GaudiLabs/qPocketPCR/Software/BOOT_Reset.jpg

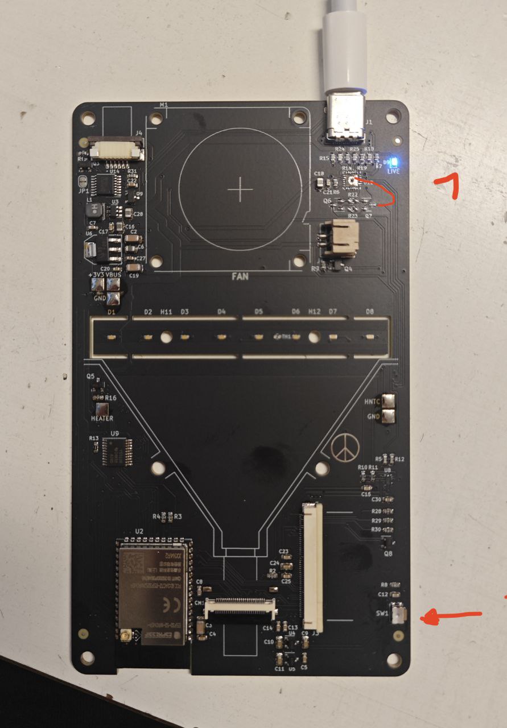
Software/BOOT_Reset.jpg
