GaudiLabs/qPocketPCR/README.md

# qPocketPCR
Quantitative PCR machine detecting fluorescence using a camera
