GaudiLabs/qPocketPCR/Electronics/LaserLid/LaserLid/LaserLid2.png

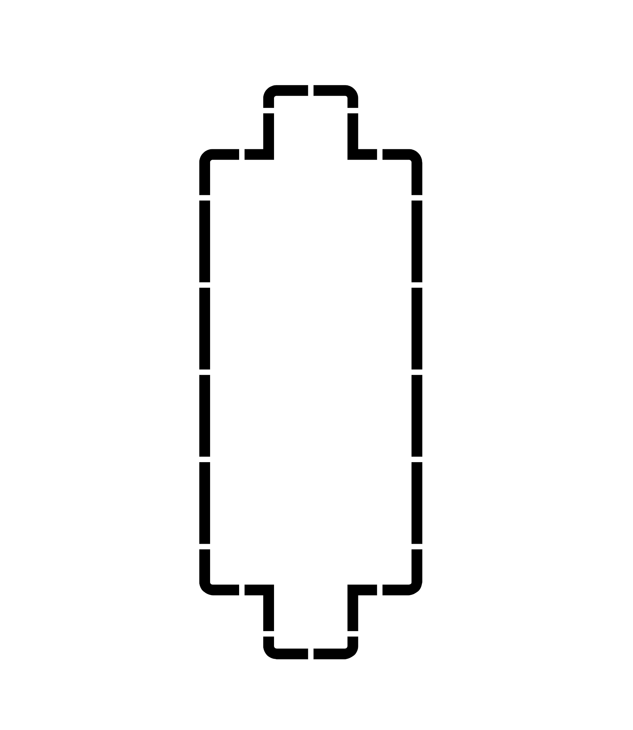
Electronics/LaserLid/LaserLid/LaserLid2.png
