GaudiLabs/qPocketPCR/Electronics/LaserLid/LaserLid/LaserLidHalve2.png

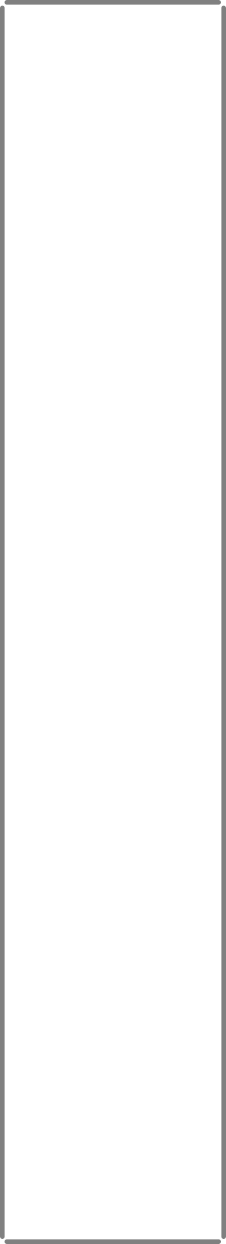
Electronics/LaserLid/LaserLid/LaserLidHalve2.png
