GaudiLabs/qPocketPCR/Electronics/TopCoverQPCR/FrontSilk.png

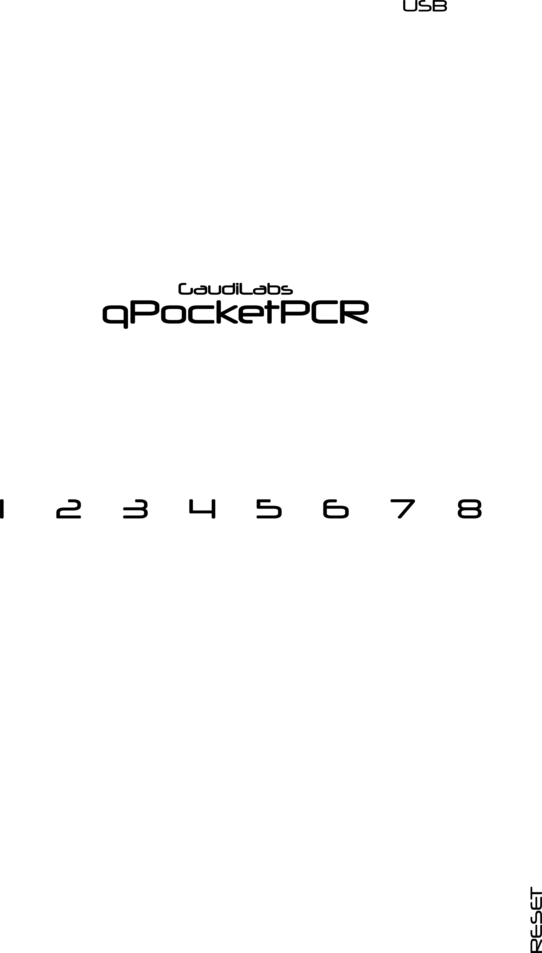
Electronics/TopCoverQPCR/FrontSilk.png
