GaudiLabs/qPocketPCR/Electronics/TopCoverQPCR/pattV2.png

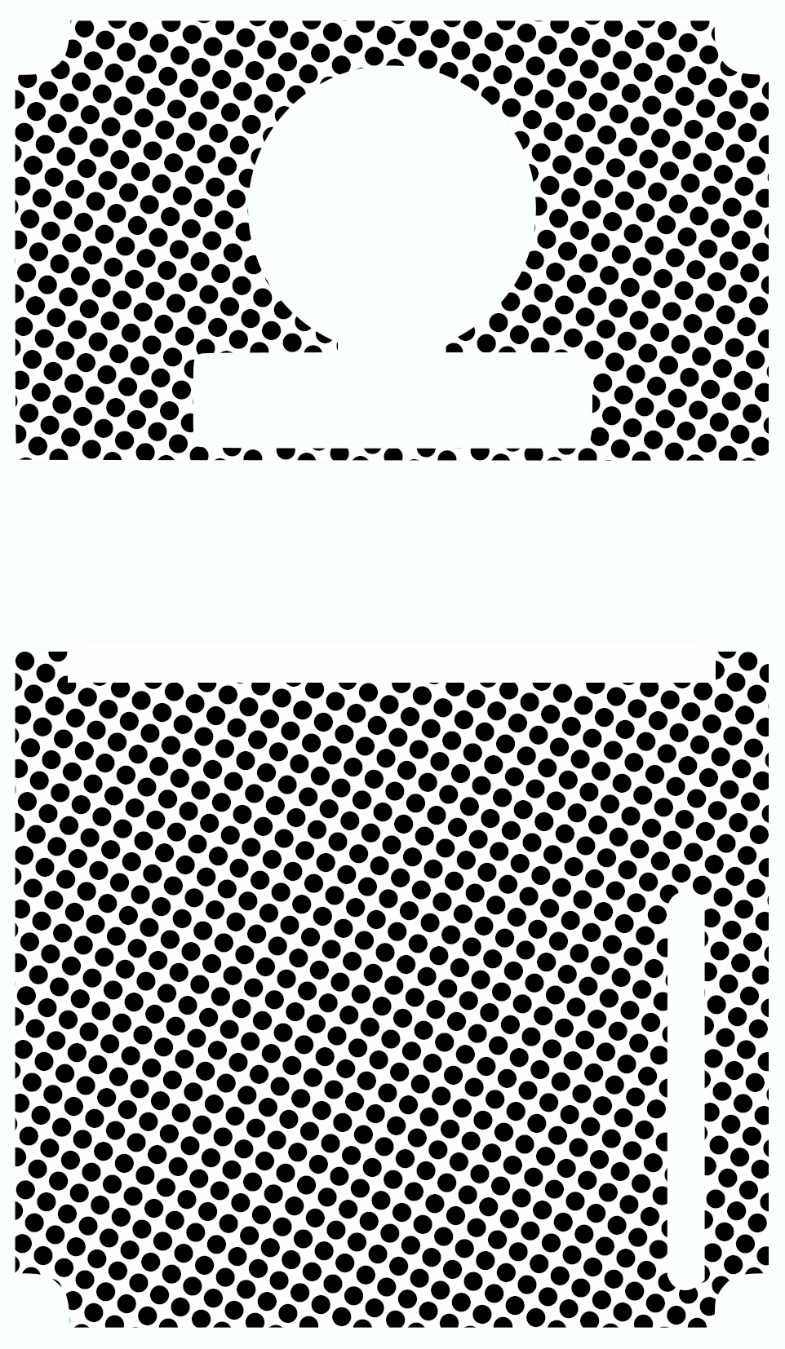
Electronics/TopCoverQPCR/pattV2.png
