GaudiLabs/qPocketPCR/Electronics/TopCoverQPCR/SilverBrim.png

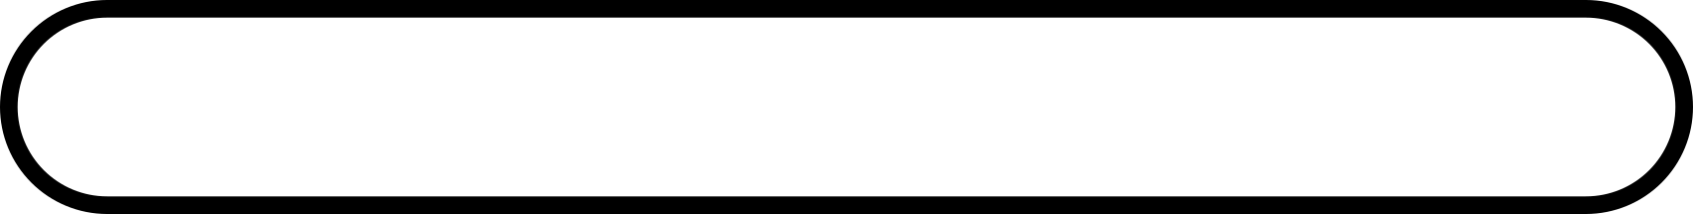
Electronics/TopCoverQPCR/SilverBrim.png
