GaudiLabs/qPocketPCR/Electronics/TopCoverQPCR/text19348-3.png

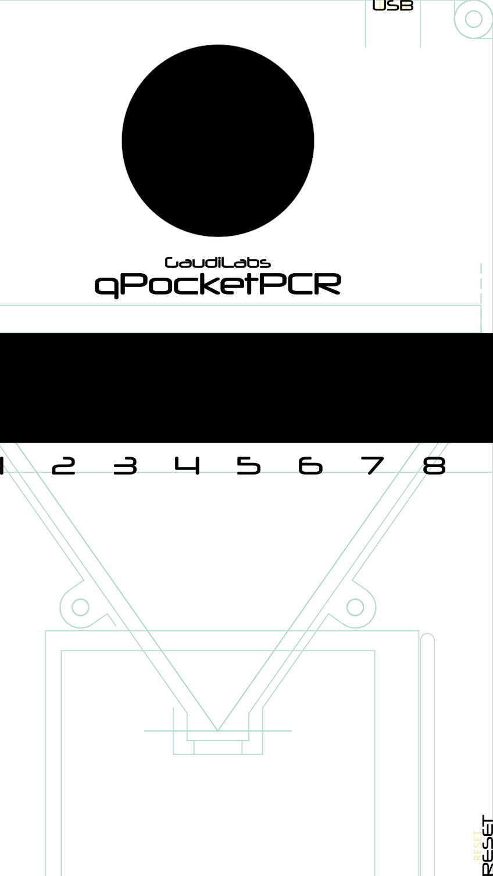
Electronics/TopCoverQPCR/text19348-3.png
