GaudiLabs/qPocketPCR/Software/SettingsqPCR.png

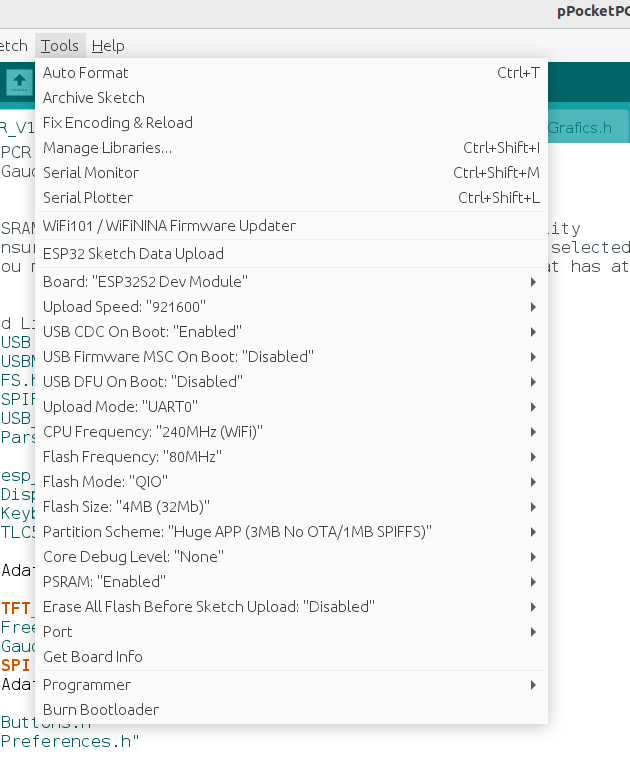
Software/SettingsqPCR.png
