GaudiLabs/qPocketPCR/Electronics/qPocketPCR_Main/qPocketPCR_Main/qCamPCR_V2_BOM.ods

 |  | BOM qPCR
Id | Quantity | Designator | Package | Designation | Supplier | Supplier and ref | Stock | Need for 25 | Stock 20205 | Ordered
1 | 1 | CM1 | FFC_MOLEX_EASYON_05mm_24_INVERTED | CAM_OV7725 | Shenzhen Duoweisi Tech Co., Ltd. |  | ok | 25 | 100
 |  |  |  | Camera Lenses | huidongbao Official Store |  |  | 25 | 100
1 |  | CM1 |  | FFC Connector 24P inverse, 5-1734592-0 | mouser | 571-5-1734592-0 |  | 25 | 10 | 20
34 | 1 | U2 | ESP32-S2-WROVER | ESP32-S2-WROVER-I(M22S2H3216UH3Q0) | mouser | 356-ESP32S2WRVI321PH | order | 25 | 1 | 50
36 | 1 | U3 | TSOT-23-6 | AP63205WU | mouser | 621-AP63205WU-7 | 9 | 25 |  | 25
12 | 1 | U4 | SOT-23 | XC6206P282MR-G | mouser | 865-XC6206P282MR-G | 8 | 25 | 3 | 25
4 | 1 | U5 | SOT-23 | XC6206P122MR-G | mouser | 865-XC6206P122MR-G | 8 | 25 | 3 | 25
35 | 1 | U6 | SOT-223 | TLV1117-33 | mouser | 595-TLV1117LV33DCYR | 8 | 25 | 5 | 25
38 | 1 | U8 | Texas_R-PUQFN-N10 | TLA2024 | digikey | TLA2024IRUGR | order | 25 | 5 | 25
42 | 1 | U9 | TSSOP-20_4.4x6.5mm_P0.65mm | TLC59108xPW | digikey | TLC59108IPWR |  | 25 | 4 | 25
37 | 1 | U12 | QFN-24-1EP_4x4mm_P0.5mm_EP2.6x2.6mm | CP2104 |  |  | 5 |  | 2
33 | 1 | U14 | TSSOP-16_4.4x5mm_P0.65mm | IP2721_MAX12 | Aliexpress |  | 8 | 25 | 3 | 25
21 | 5 | Q3,Q4,Q5,Q8,Q9 | SOT-23 | Q_NMOS_GSD, AO3420 |  |  | order | 125 | 50 | 100
25 | 2 | Q6,Q7 | SOT-23 | BC847_NPN_BEC |  |  | 100
5 | 8 | D1,D2,D3,D4,D5,D7,D6,D8 | LED_SMD_WL-SMCW | LED WL-SMCW (150060BS84000) | LB Q39G-L200-35-1 | 720-LBQ39GL2N2351 |  | 200 | 40 | 200
23 | 1 | D9 | LED_0603_1608Metric | LED green |  |  | ok | 25
39 | 1 | L1 | L_Vishay_IFSC-1515AH_4x4x1.8mm | 4.7uHNRS4018T4R7MDGJ | digikey | 587-2893-2-ND | 10 | 25 | 5 | 25 | +10 other?
30 | 1 | LID | C_0402_1005Metric | Thermistor_NTC |  |  | ok
 | 1 | TH1 |  | NXFT15XV103FEAB021 | mouser | 81-NXFT15XV103FEAB21 |  |  | 4 | 25
15 | 3 | C2,C3,C19 | C_1206_3216Metric | 100uF |  |  | ok
16 | 14 | C4,C5,C7,C12,C13,C15,C20,C21,C23,C25,C27,C14,C30,C17 | C_0603_1608Metric | 100nF |  |  | ok
17 | 4 | C6,C28,C18,C16 | C_0805_2012Metric | 22uF |  | 47uF | ok
18 | 1 | C8 | C_0603_1608Metric | 15pF |  |  | ok
19 | 4 | C9,C10,C11,C24 | C_0805_2012Metric | 10uF |  |  | ok
31 | 1 | C22 | C_0603_1608Metric | 1uF |  |  | ok
6 | 6 | R1, R2,R3,R4,R9,R16 | R_0603_1608Metric | 4.7k
 | 2 | R10,R11 | R_0603_1608Metric | 4.7k 0.1%
7 | 4 | R7,R8,R12 | R_0603_1608Metric | 1k
8 | 3 | R28,R29,R30 | R_0603_1608Metric | 18R
9 | 4 | R24,R25,R14,R15 | R_0603_1608Metric | 22R
10 | 2 | R18,R19 | R_0603_1608Metric | 5k1
11 | 1 | R31 | R_0603_1608Metric | 100k
41 | 1 | R13 | R_0603_1608Metric | 3.3k |  |  | 100 | 25 | 95
24 | 3 | R23,R22,R6,R5 | R_0603_1608Metric | 10k
27 | 1 | SW1 | SW_SPST_KMS221GLFS | SW_Push |  |  | ok
2 | 1 | J1 | USB_C_Receptacle_Amphenol_12401610E4-2A | USB_C_Receptacle |  |  | ok | 25 | 25
22 | 1 | J2 | JSP_PH_20_SMD_RIGHT_ANGLE | FAN_12V | Aliexpress |  | 4 | 25 | 15 | 60
3 | 1 | Disp | ER-TFT022_1 | ER-TFT022-1 | buydisplay.com | ER-TFT022-1, 2.2“, Capacitive Touch Panel | 8 | 25 | 5
 | 1 | J3 |  | 50 pin ZIF connector | digikey | A100227CT-ND |  | 25 | 3 | 25
 | 1 | J4 |  | FFC Connector 6pin, FFC3B07-06-T | mouser | 640-FFC3B07-06-T |  | 25 | 9 | 25
 |  | Lid Cable |  | FFC Cable 6pin 1mm, Capton | Aliexpress |  |  |  |  | 10
43 | 1 | M1 | 4010FanRadial | Fan, Radial Blower 12v |  |  | 4 | 25 | 2 | 8
 | 1 |  |  | Thermal Conductive Paste |  |  | 1
 |  |  |  | Graphite Sheet |  |  | 1
 | 1 |  |  | Heatblock |  |  |  | 25 | 3
 | 1 |  |  | PCB Lid |  |  |  | 25
 | 1 |  |  | PCB Top Cover |  |  |  | 25
 | 1 |  |  | PCB Main |  |  |  | 25
 | 1 |  |  | 3D printed frame |  |  |  | 25
 | 1 |  |  | 3D printed Display Bezzel |  |  |  | 25
 | 1 |  |  | 3D printed Lid |  |  |  | 25
 | 1 |  |  | 3D printed corner left
 | 1 |  |  | 3D printed corner right
 | 2 |  |  | Sink Screw 5mm | BN3803. M2.5 x 5 mm, 83.1325.02505
 | 8 |  |  | Screw Black M3 x 8
 | 4 |  |  | Screws Black M2.5x 8 (6)
 | 4 |  |  | Spacers M3x10mm
 | 1 |  |  | Foam for heated lid
 | 1 |  |  | Silicon Heat pad
 | 1 |  |  | 0.2mm Laser Lid
 | 1 |  |  | Filter blue | (HT)*141 BRIGHT BLUE p72
 | 1 |  |  | Filter orange | 780 AS GOLDEN AMBER
 | 1 |  |  | Thermal Conductive Carbon Sheet
13 | 6 | H1,H2,H3,H4,H5,H6 | MountingHole_3.2mm_M3 | CaseMountingHole
29 | 2 | H12,H11 | MountingHole_2.6mm | HeatblockMountingHole
