GaudiLabs/qPocketPCR/Hardware/SolidWorks/qPocketPCR_Assembly.SLDASM

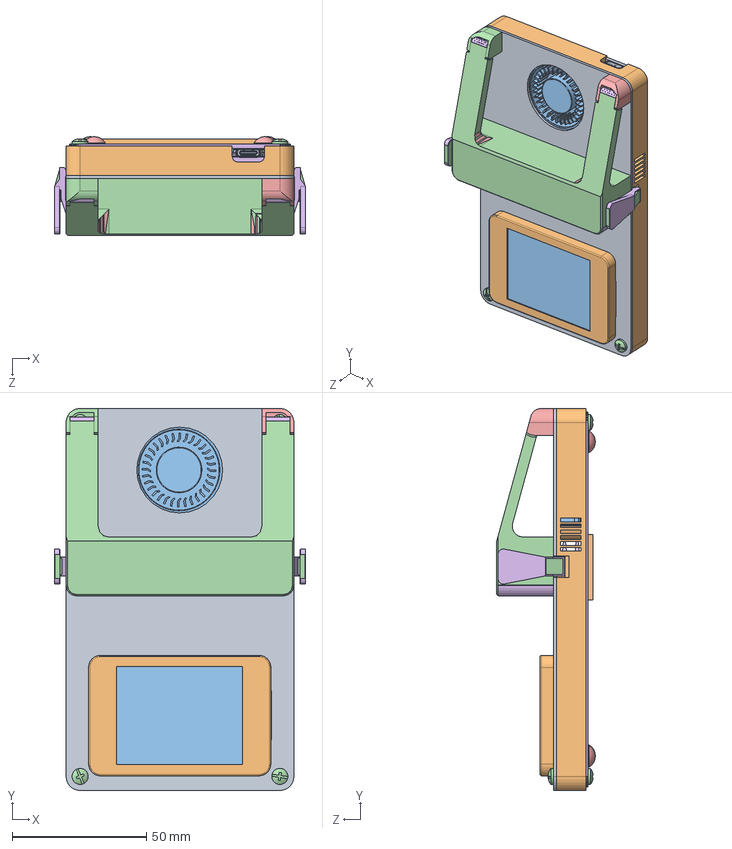
[picture p9: CAD file, 2025-11-05]
Hardware/SolidWorks/qPocketPCR_Assembly.SLDASM
93.8 x 142.5 x 36.8 mm
Frame2
HexNutM3_10 x 4
Screw x 8
Feet x 4
Heatblock451
FilterBlue
Cam
PCBTop
BezzelClip
Display2_2
HingeCorner
HingeCornerMirrored
CapHeatedNewClip
LidHeatGuideSheet
TubeStrip
FilterOrange
CarbonPatch
My4010Blowe
SOLID.step x 9
SOLID-0.step x 26
SOLID-1.step x 3
SOLID-2.step x 16
SOLID-3.step x 8
SOLID-4.step
SOLID-5.step
SOLID-6.step
SOLID-7.step
SOLID-8.step
qPocketPCR_Main PCB.step
BlueLED0402 x 2
NTC_NXFT15
C12401610_3
SiliconPad
