GaudiLabs/qPocketPCR/Electronics/qCamPCB/svg/qCamPCR-brd.dxf

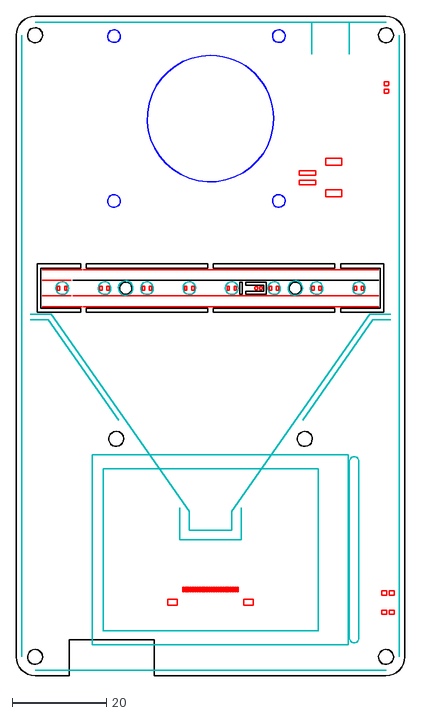
[picture p10: CAD file, 2025-11-05]
Electronics/qCamPCB/svg/qCamPCR-brd.dxf
82.5 x 140.0
