GaudiLabs/qPocketPCR/Electronics/qPocketPCR_Lid/outline.dxf

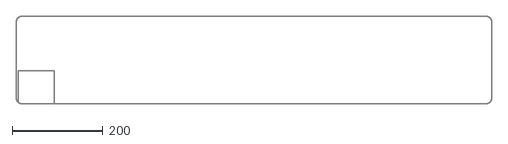
[picture p11: CAD file, 2025-11-05]
Electronics/qPocketPCR_Lid/outline.dxf
1047.6 x 193.3
