GaudiLabs/qPocketPCR/Electronics/TopCoverQPCR/TopCoverCAD.dxf

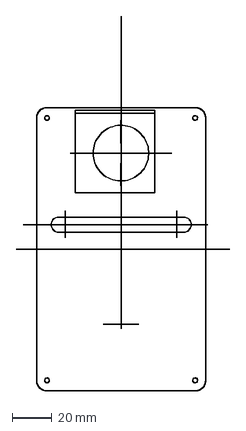
[picture p12: CAD file, 2025-11-05]
Electronics/TopCoverQPCR/TopCoverCAD.dxf
107.6 x 188.5 mm
