GaudiLabs/qPocketPCR/Hardware/SolidWorks/Display2_2.SLDPRT

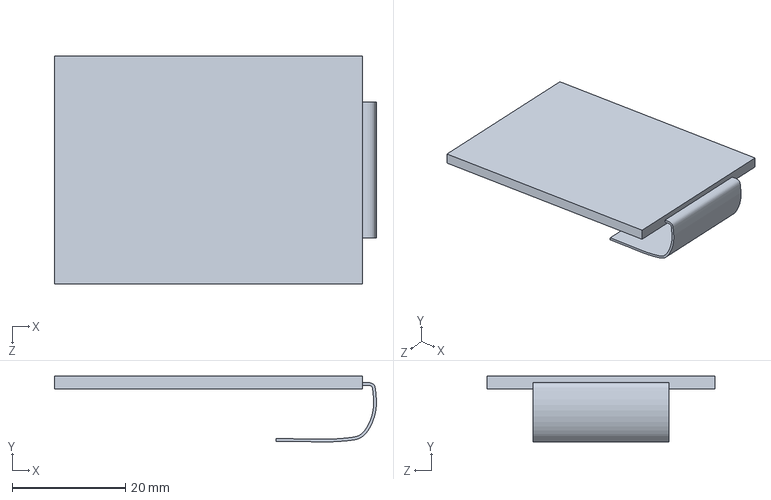
[picture p13: CAD file, 2025-11-05]
Hardware/SolidWorks/Display2_2.SLDPRT
56.9 x 11.6 x 40.3 mm
