GaudiLabs/qPocketPCR/Electronics/qCamPCB/svg/DrawingQpcr.dxf

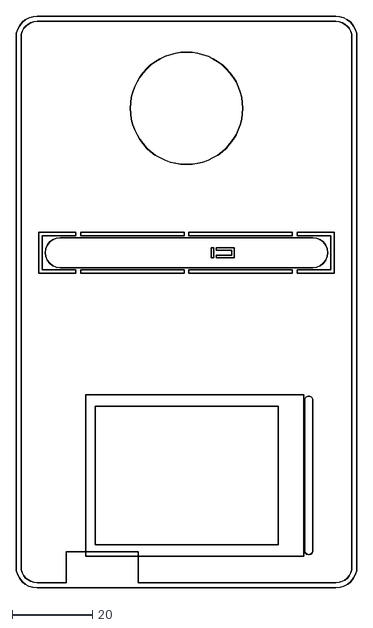
[picture p14: CAD file, 2025-11-05]
Electronics/qCamPCB/svg/DrawingQpcr.dxf
85.0 x 142.5
