GaudiLabs/qPocketPCR/Hardware/SolidWorks/SiliconPad.SLDPRT

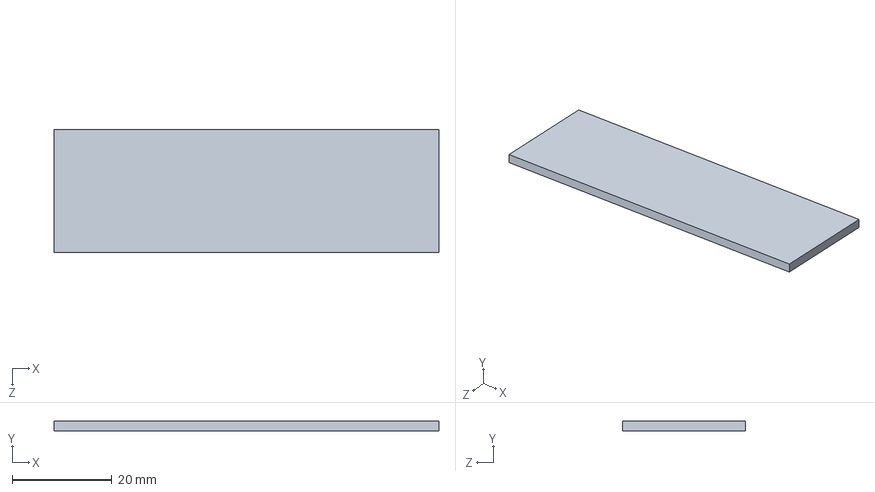
[picture p15: CAD file, 2025-11-05]
Hardware/SolidWorks/SiliconPad.SLDPRT
77.0 x 2.00 x 24.5 mm
