GaudiLabs/qPocketPCR/Hardware/SolidWorks/CarbonPatch.SLDPRT

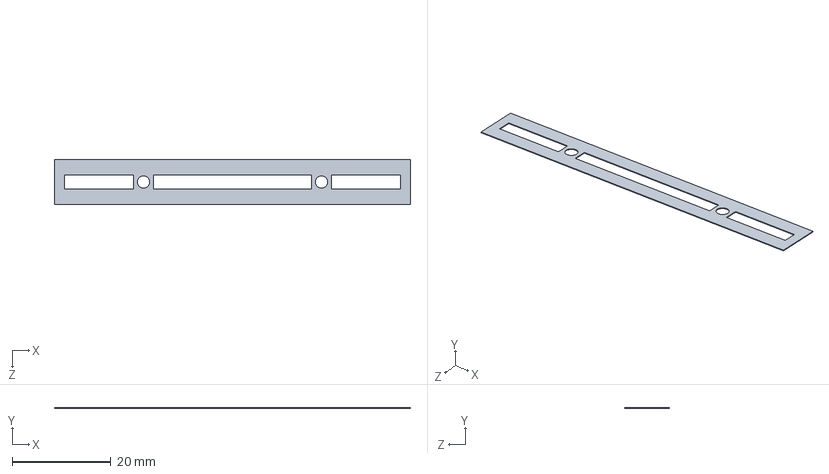
[picture p16: CAD file, 2025-11-05]
Hardware/SolidWorks/CarbonPatch.SLDPRT
72.0 x 0.15 x 9.00 mm
