GaudiLabs/qPocketPCR/Hardware/SolidWorks/My4010Blowe.SLDPRT

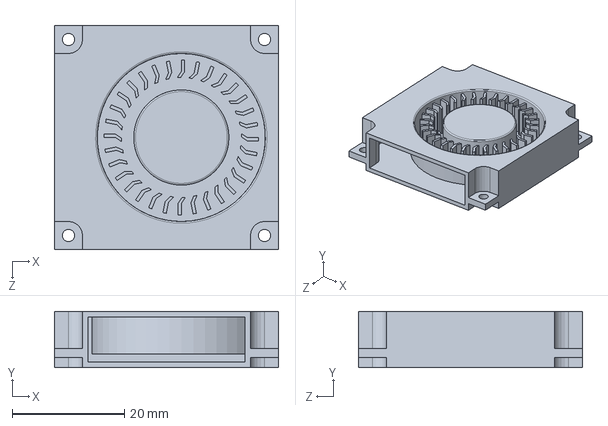
[picture p17: CAD file, 2025-11-05]
Hardware/SolidWorks/My4010Blowe.SLDPRT
40.0 x 10.0 x 40.0 mm
