GaudiLabs/qPocketPCR/Hardware/SolidWorks/HingeCorner.SLDPRT

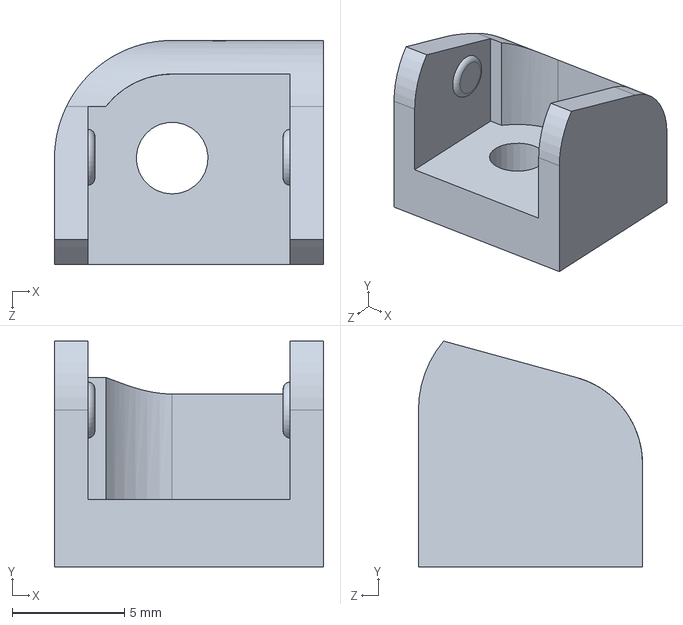
[picture p18: CAD file, 2025-11-05]
Hardware/SolidWorks/HingeCorner.SLDPRT
12.0 x 10.1 x 10.00 mm
