GaudiLabs/qPocketPCR/Hardware/SolidWorks/BlueLED0402.SLDPRT

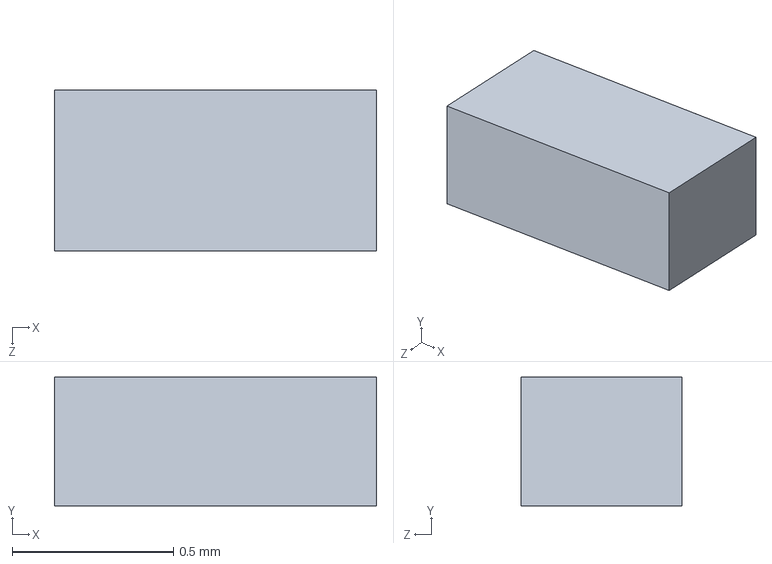
[picture p19: CAD file, 2025-11-05]
Hardware/SolidWorks/BlueLED0402.SLDPRT
1.00 x 0.4 x 0.5 mm
