GaudiLabs/qPocketPCR/Hardware/SolidWorks/Cam.SLDPRT

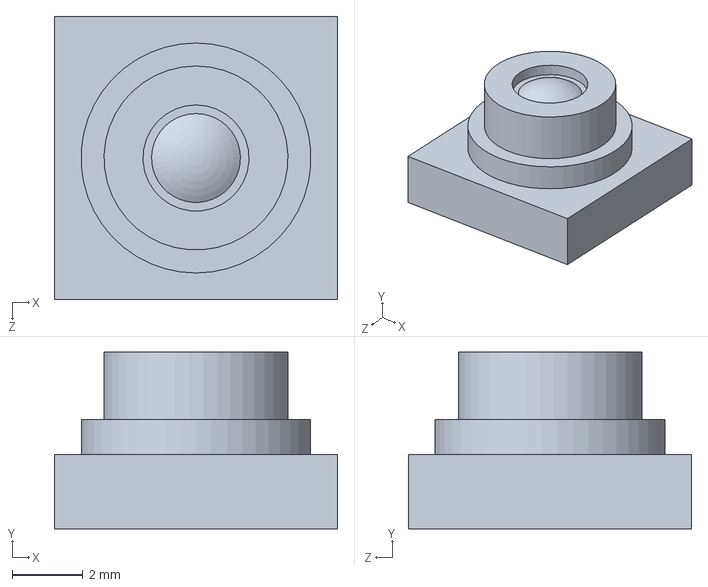
[picture p20: CAD file, 2025-11-05]
Hardware/SolidWorks/Cam.SLDPRT
8.00 x 5.00 x 8.00 mm
