GaudiLabs/qPocketPCR/Hardware/SolidWorks/PCBV12.SLDPRT

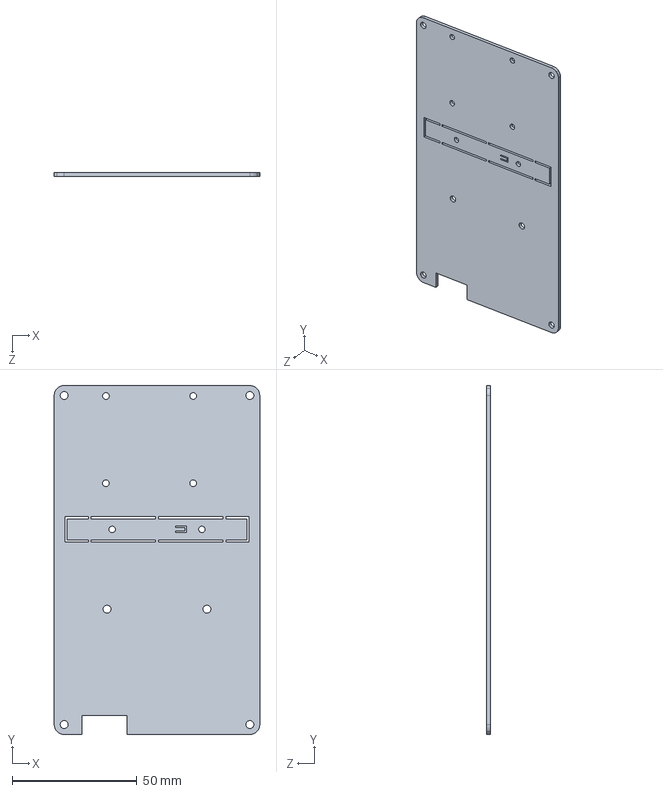
[picture p21: CAD file, 2025-11-05]
Hardware/SolidWorks/PCBV12.SLDPRT
82.5 x 140.0 x 1.60 mm
