GaudiLabs/qPocketPCR/Hardware/SolidWorks/FilterOrange.SLDPRT

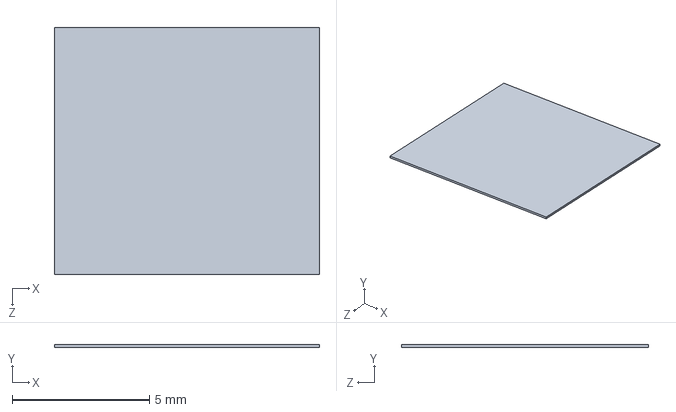
[picture p22: CAD file, 2025-11-05]
Hardware/SolidWorks/FilterOrange.SLDPRT
9.65 x 0.1 x 9.00 mm
