GaudiLabs/qPocketPCR/Hardware/SolidWorks/CapHeatedNewClip.SLDPRT

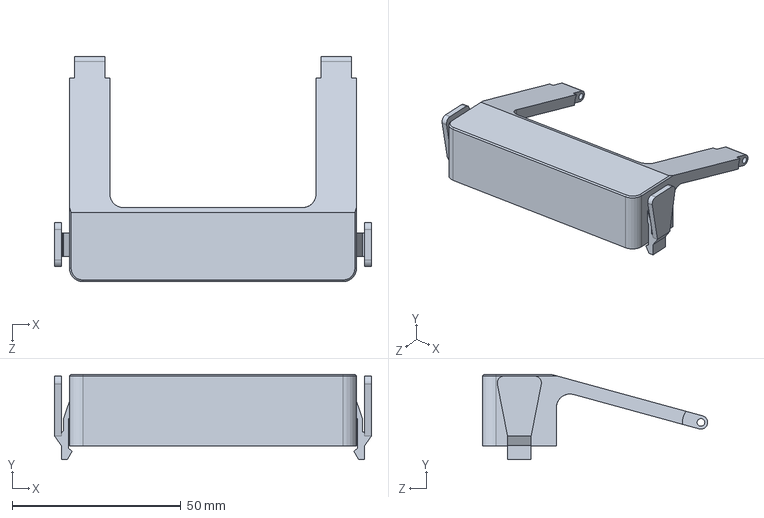
[picture p23: CAD file, 2025-11-05]
Hardware/SolidWorks/CapHeatedNewClip.SLDPRT
93.8 x 25.2 x 66.7 mm
