GaudiLabs/qPocketPCR/Hardware/SolidWorks/PCBTop.SLDPRT

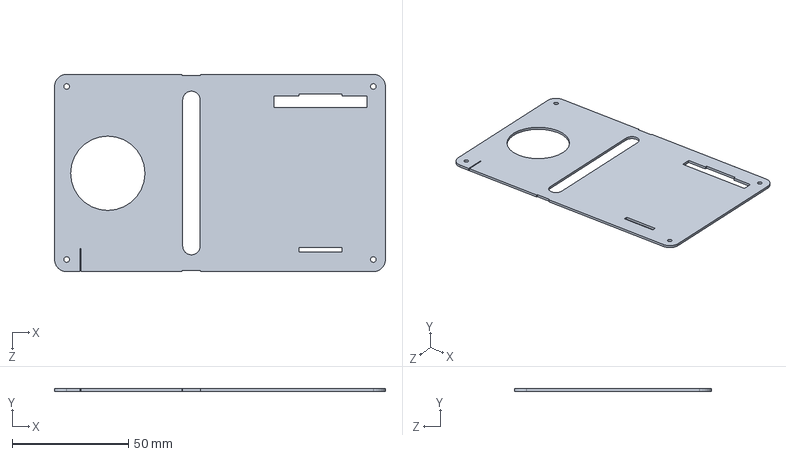
[picture p24: CAD file, 2025-11-05]
Hardware/SolidWorks/PCBTop.SLDPRT
142.5 x 1.20 x 85.0 mm
