GaudiLabs/qPocketPCR/Hardware/SolidWorks/TubeStrip.SLDPRT

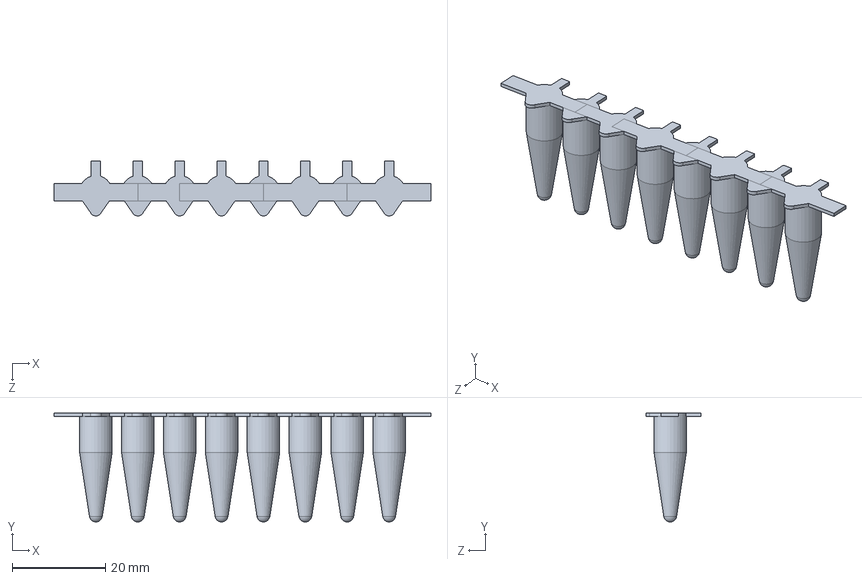
[picture p25: CAD file, 2025-11-05]
Hardware/SolidWorks/TubeStrip.SLDPRT
81.0 x 23.4 x 11.8 mm
