GaudiLabs/qPocketPCR/Hardware/SolidWorks/NTC_NXFT15.SLDPRT

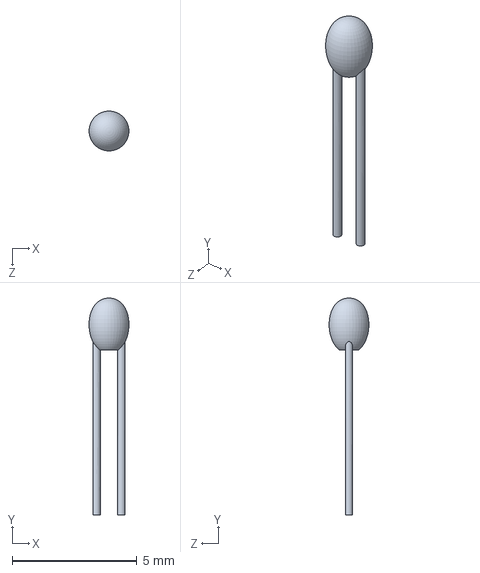
[picture p26: CAD file, 2025-11-05]
Hardware/SolidWorks/NTC_NXFT15.SLDPRT
1.60 x 8.69 x 1.59 mm
