GaudiLabs/qPocketPCR/Hardware/SolidWorks/BezzelClip.SLDPRT

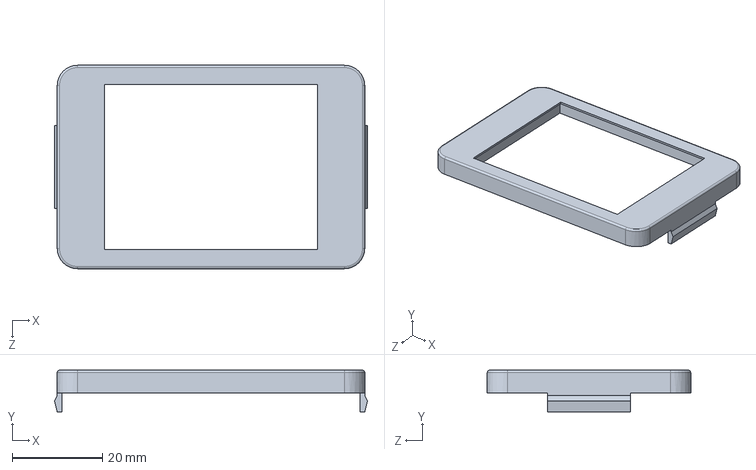
[picture p27: CAD file, 2025-11-05]
Hardware/SolidWorks/BezzelClip.SLDPRT
69.2 x 9.20 x 45.0 mm
