GaudiLabs/qPocketPCR/Hardware/SolidWorks/FilterBlue.SLDPRT

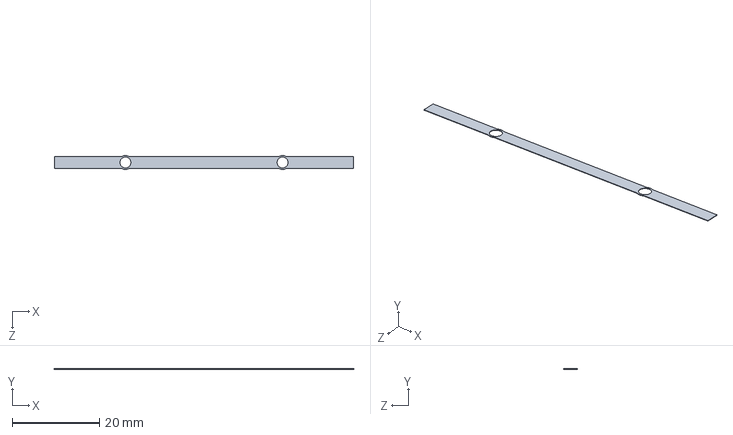
[picture p28: CAD file, 2025-11-05]
Hardware/SolidWorks/FilterBlue.SLDPRT
68.5 x 0.1 x 3.20 mm
