GaudiLabs/qPocketPCR/Hardware/SolidWorks/HexNutM3_10.SLDPRT

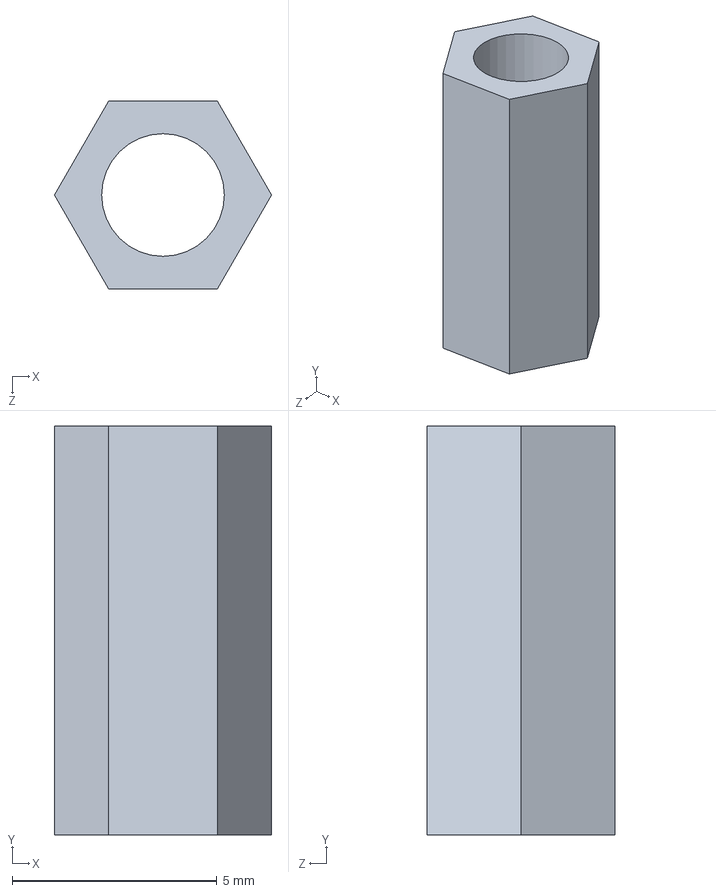
[picture p29: CAD file, 2025-11-05]
Hardware/SolidWorks/HexNutM3_10.SLDPRT
5.31 x 10.0 x 4.60 mm
