GaudiLabs/qPocketPCR/Hardware/SolidWorks/LidHeatGuideSheet.SLDPRT

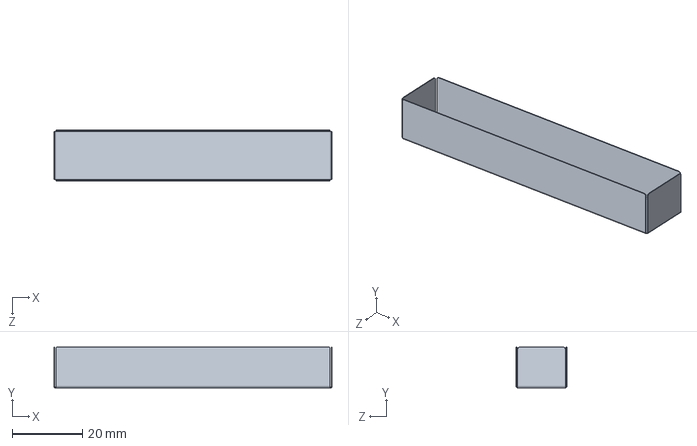
[picture p30: CAD file, 2025-11-05]
Hardware/SolidWorks/LidHeatGuideSheet.SLDPRT
79.0 x 11.6 x 14.4 mm
