GaudiLabs/qPocketPCR/Hardware/SolidWorks/Frame2.SLDPRT

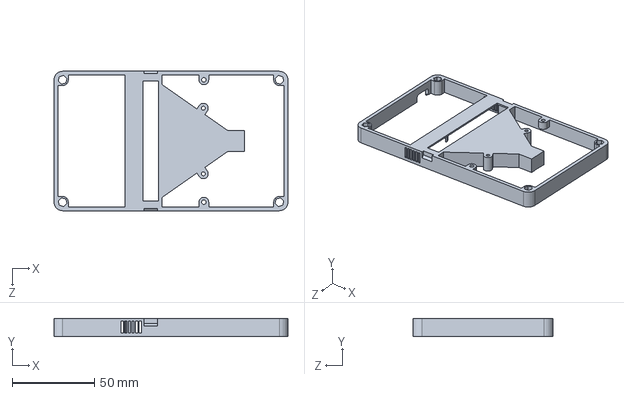
[picture p31: CAD file, 2025-11-05]
Hardware/SolidWorks/Frame2.SLDPRT
142.5 x 11.0 x 85.0 mm
