GaudiLabs/qPocketPCR/Hardware/SolidWorks/Feet.SLDPRT

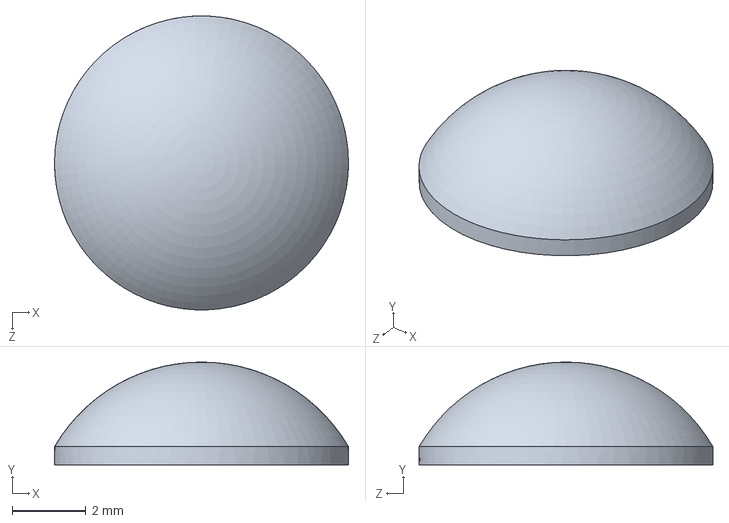
[picture p32: CAD file, 2025-11-05]
Hardware/SolidWorks/Feet.SLDPRT
8.00 x 2.80 x 8.00 mm
