GaudiLabs/qPocketPCR/Hardware/SolidWorks/Heatblock451.SLDPRT

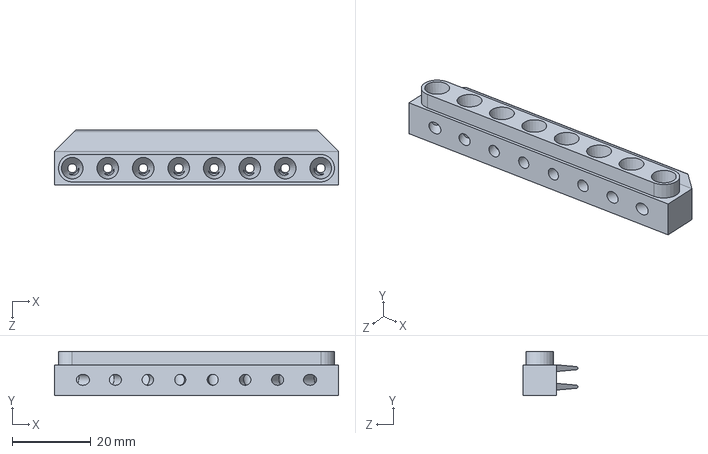
[picture p33: CAD file, 2025-11-05]
Hardware/SolidWorks/Heatblock451.SLDPRT
72.0 x 11.2 x 13.9 mm
