GaudiLabs/qPocketPCR/(list of files, cad)

Other CAD files:
Electronics/LaserLid/LidHeatGuideSheet.DWG
Electronics/qPocketPCR_Lid/#HeatedLidPCB.dwg
Hardware/SolidWorks/HingeCornerMirrored.SLDPRT
Electronics/qPocketPCR_Lid/HeatedLidPCB.dwg
Hardware/SolidWorks/C12401610_3.SLDPRT
Hardware/SolidWorks/Screw.SLDPRT
