GaudiLabs/qPocketPCR/Electronics/LaserLid/LidHeatGuideSheet2.PDF

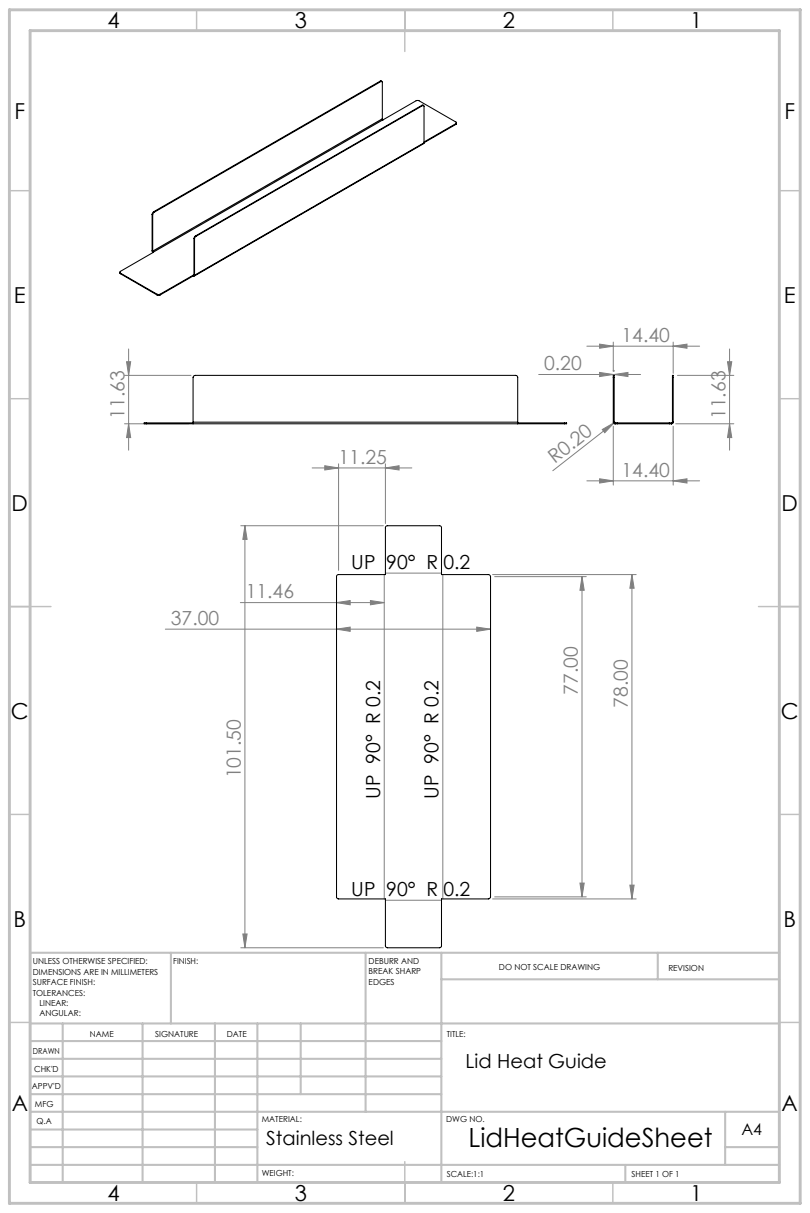
[picture p34: page 1]
FINISH:; DEBURR AND; BREAK SHARP; DO NOT SCALE DRAWING; REVISION; SCALE:1:1; SHEET 1 OF 1

UNLESS OTHERWISE SPECIFIED:
DIMENSIONS ARE IN MILLIMETERS
SURFACE FINISH:
TOLERANCES:
LINEAR:
ANGULAR:

NAME | SIGNATURE | DATE | | | | TITLE: Lid Heat Guide

DRAWN
CHK'D
APPV'D
MFG
Q.A | | | | MATERIAL: Stainless Steel | DWG NO. LidHeatGuideSheet | A4
