GaudiLabs/qPocketPCR/Electronics/qPocketPCR_Lid/qPocketPCR_Lid/qPocketPCR_Lid.kicad_pcb

## KiCad design Electronics/qPocketPCR_Lid/qPocketPCR_Lid/qPocketPCR_Lid.kicad_pcb (2025-11-05)

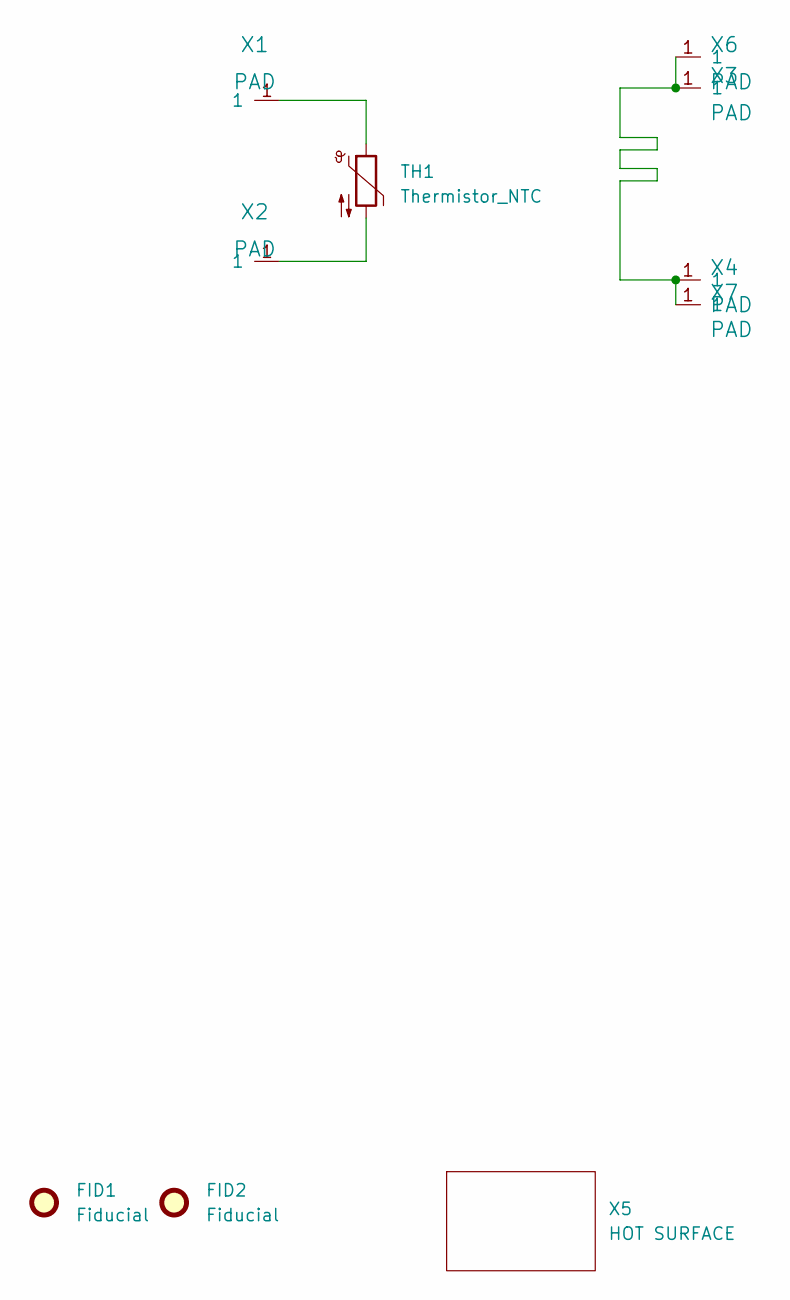
[picture p35: schematic qPocketPCR_Lid.kicad_sch]

Parts:
FID1, FID2: Fiducial; Fiducial_0.5mm_Mask1mm
TH1: Thermistor_NTC; R_0402_1005Metric
X1, X2, X3, X4, X6, X7: PAD; PAD_SMD_FFC
X5: HOT SURFACE; HotSurfaceWarning

Connections:
unnamed: TH1.1, X1.1
unnamed: TH1.2, X2.1
unnamed: X3.1, X4.1, X6.1, X7.1

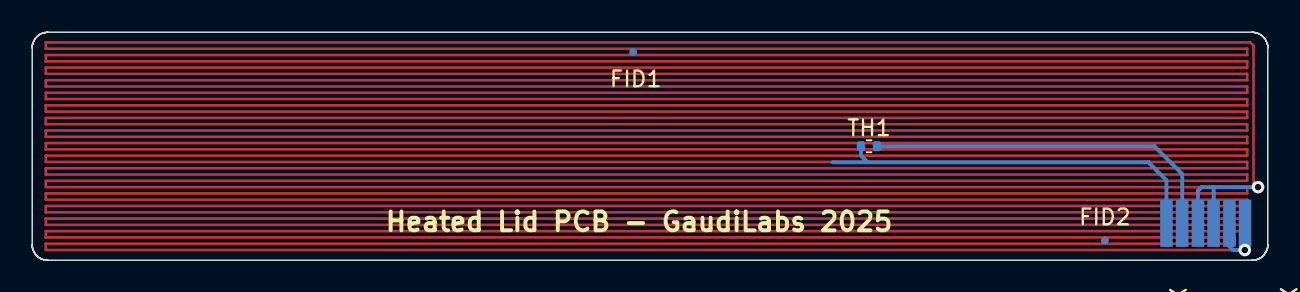
[picture p36: board qPocketPCR_Lid.kicad_pcb from below]

Board: 2 copper layers, 78.6 x 14.5 mm, 10 parts (9 on the bottom side), 3 nets.
