GaudiLabs/qPocketPCR/Electronics/qCamPCB/qCamPCR.kicad_pcb

## KiCad design Electronics/qCamPCB/qCamPCR.kicad_pcb (2025-11-05)

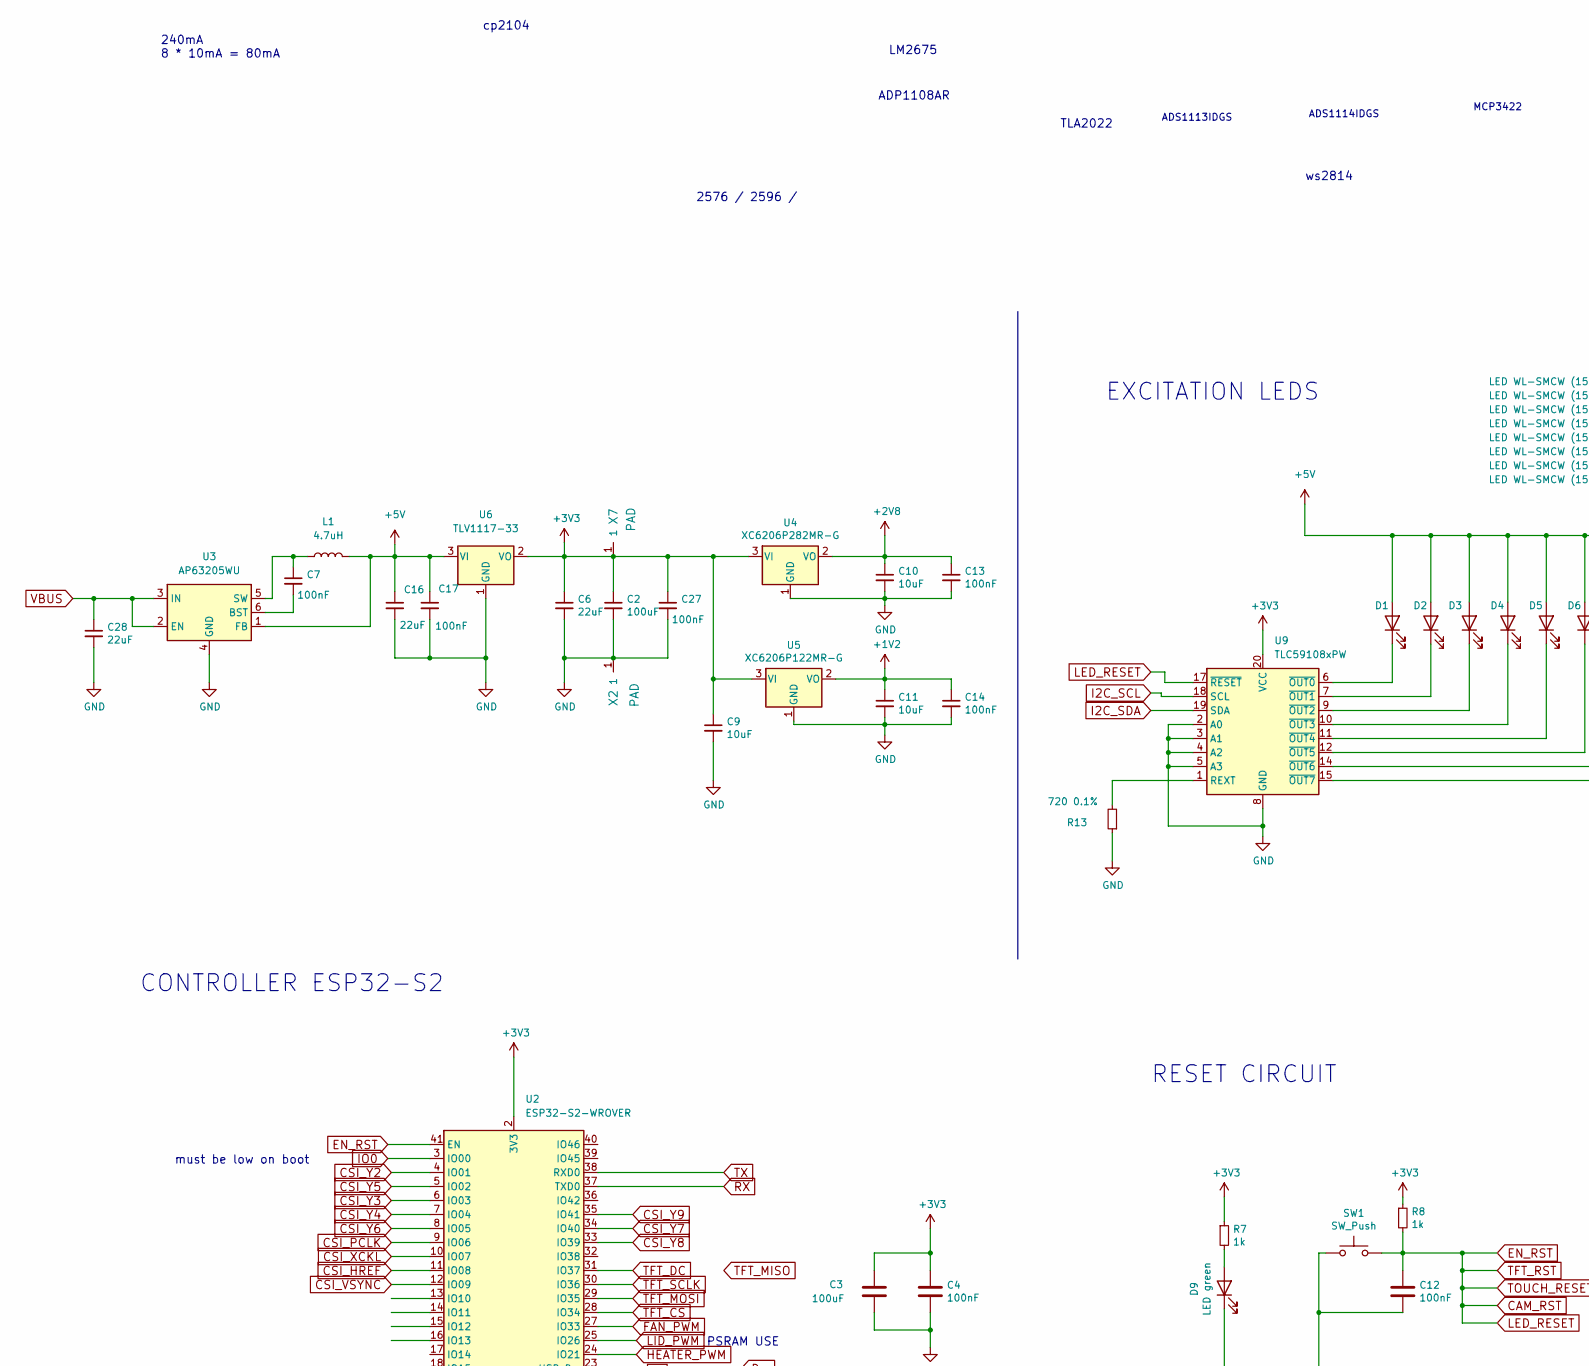
[picture p37: schematic qCamPCR.kicad_sch, qPocketPCR, part in row 1, column 1]

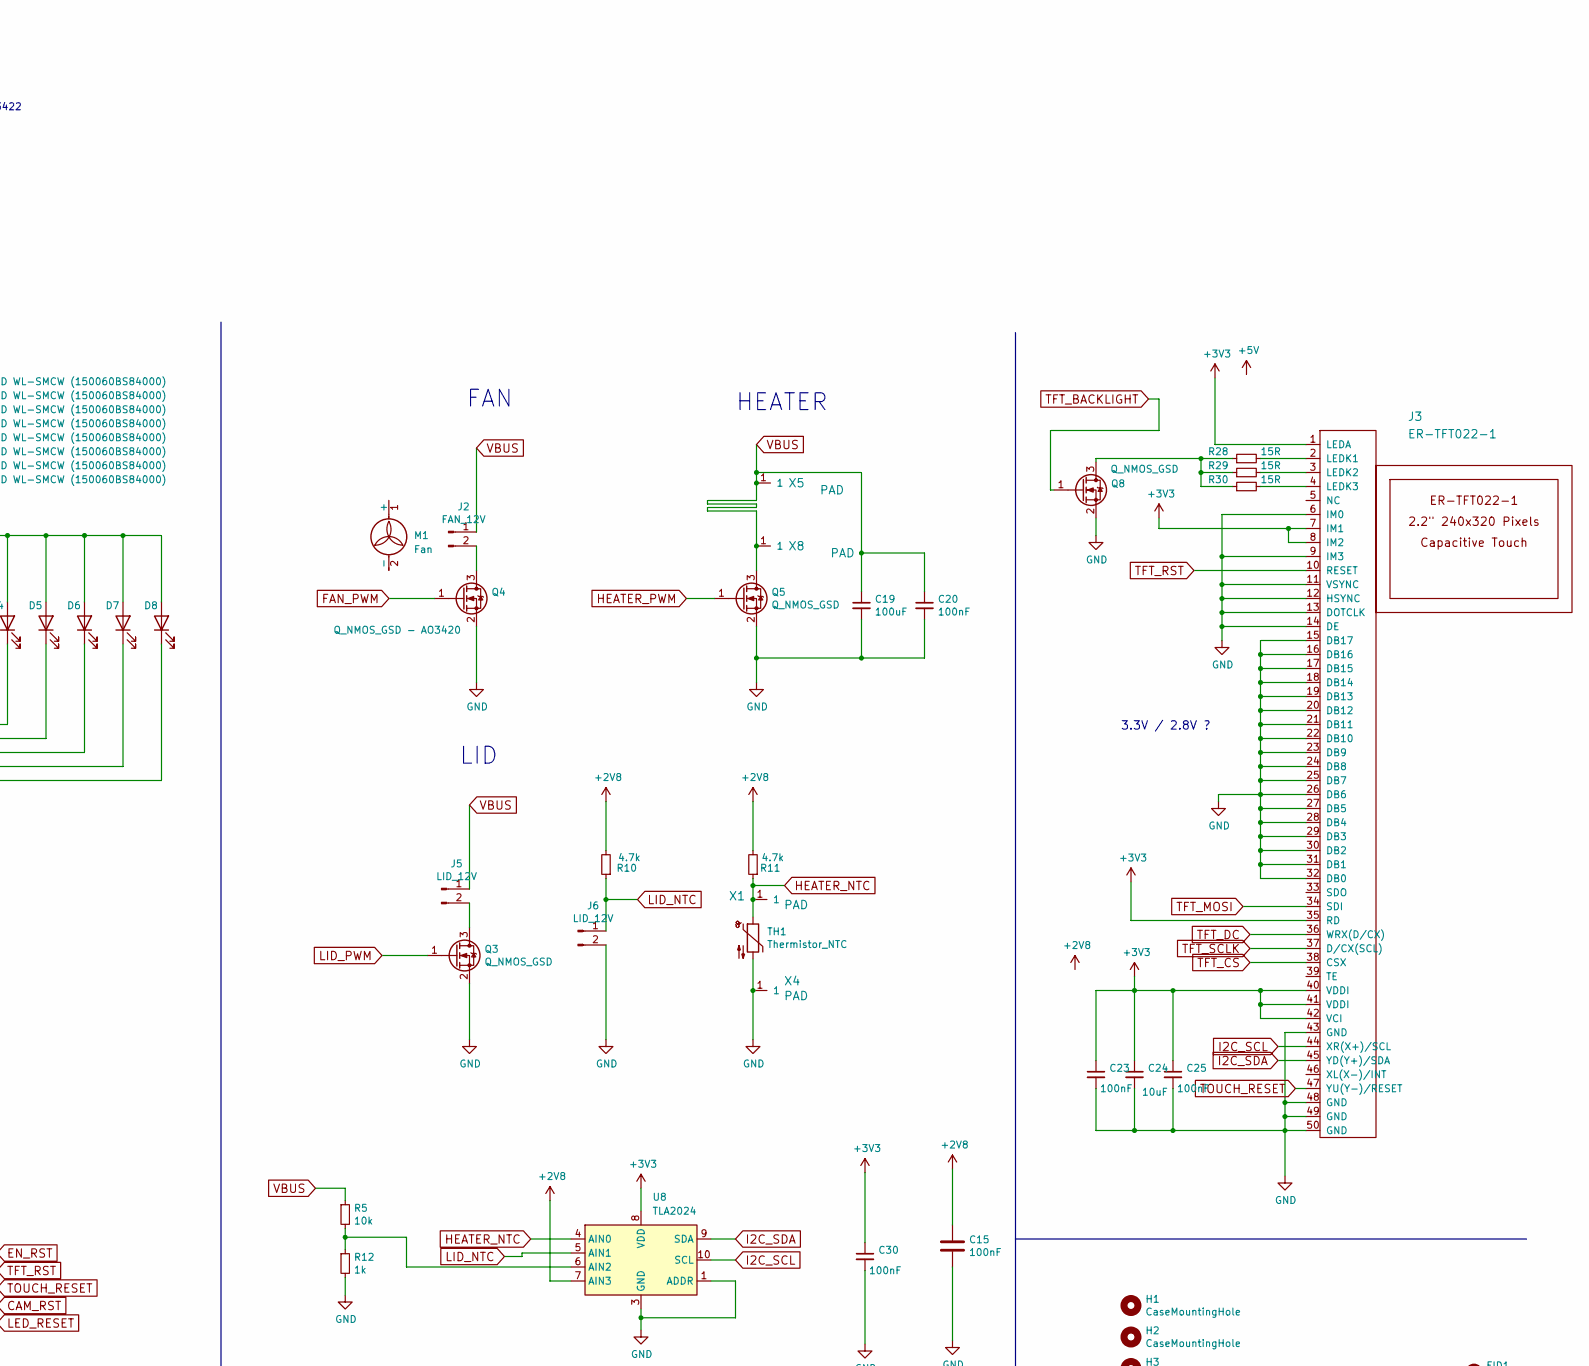
[picture p38: schematic qCamPCR.kicad_sch, qPocketPCR, part in row 1, column 2]

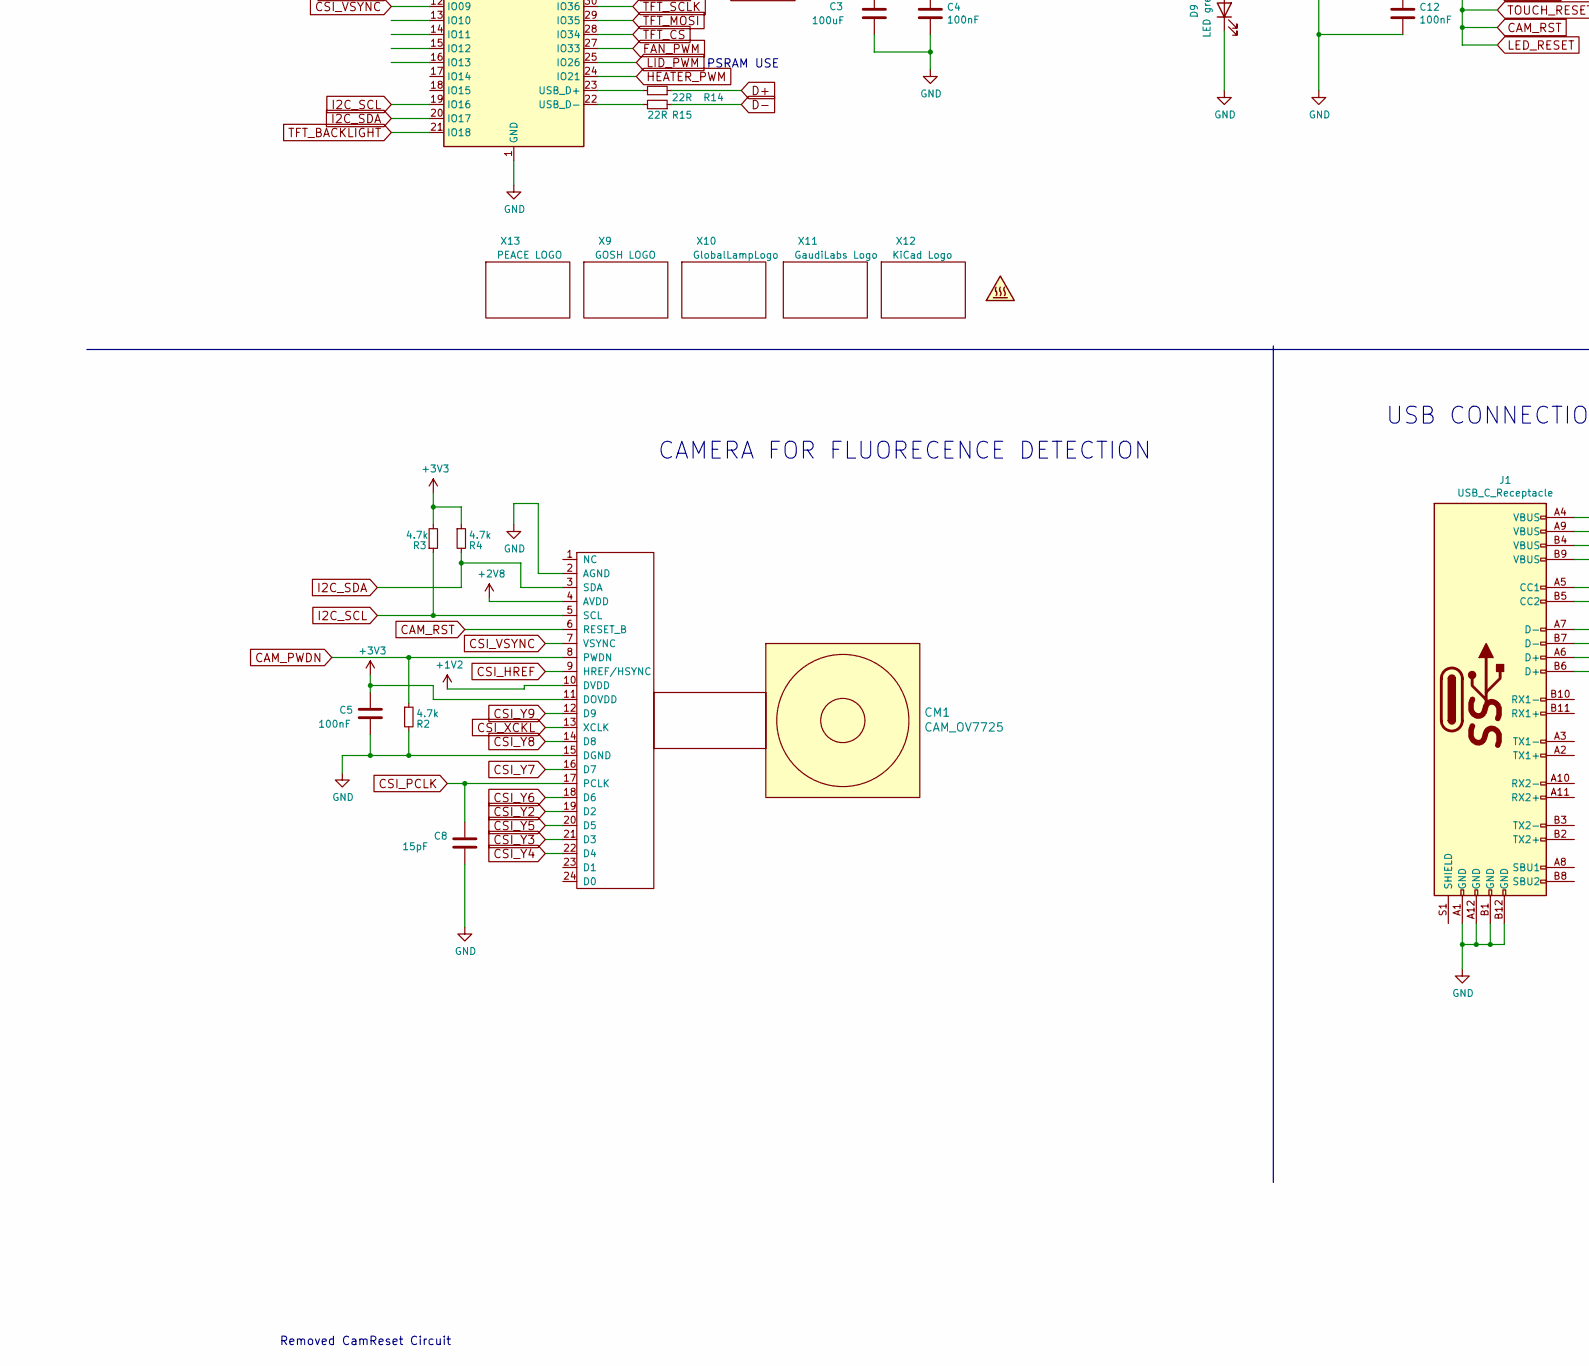
[picture p39: schematic qCamPCR.kicad_sch, qPocketPCR, part in row 2, column 1]

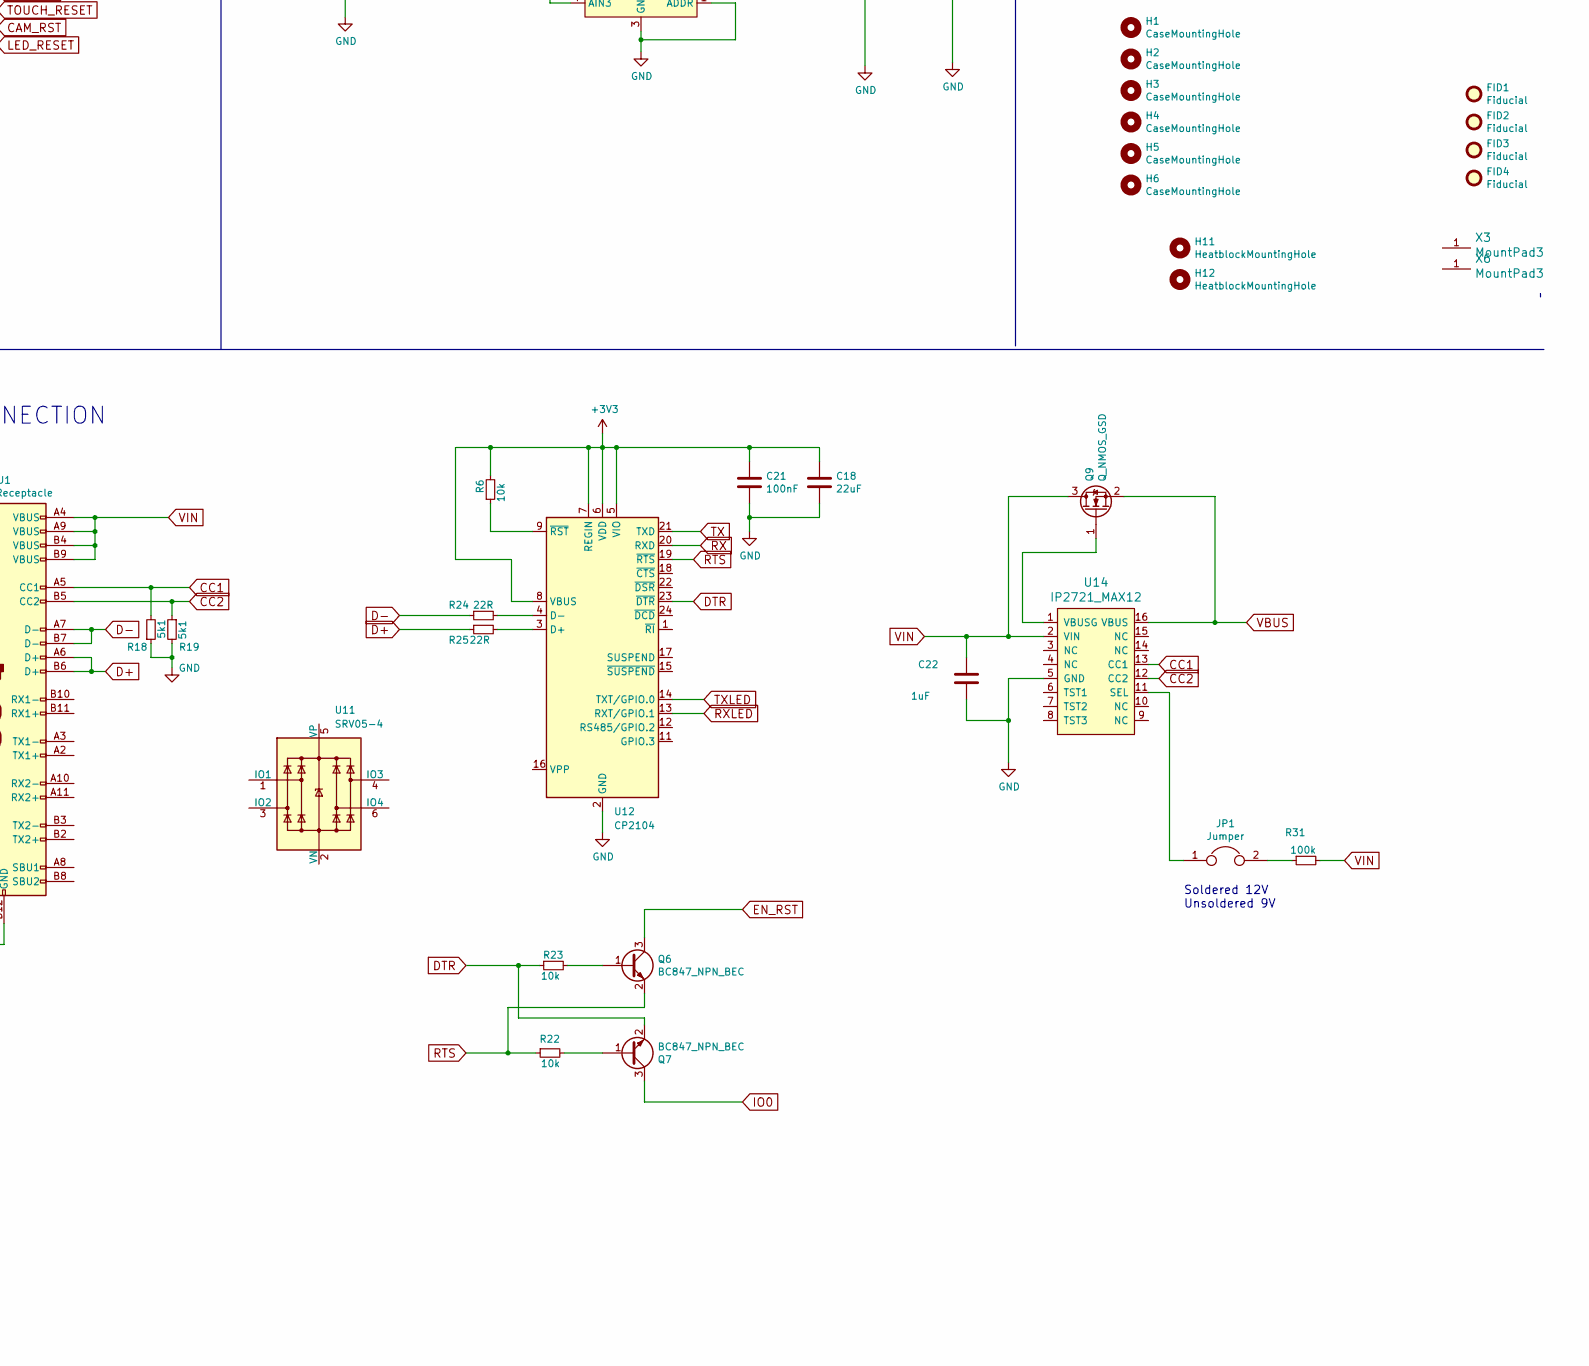
[picture p40: schematic qCamPCR.kicad_sch, qPocketPCR, part in row 2, column 2]

Parts:
C2, C3, C19: 100uF; C_1206_3216Metric
C4, C5, C7, C12, C13, C14, C15, C17, C20, C21, C23, C25, C27, C30: 100nF; C_0603_1608Metric
C6, C16, C18, C28: 22uF; C_0805_2012Metric
C8: 15pF; C_0603_1608Metric
C9, C10, C11, C24: 10uF; C_0805_2012Metric
C22: 1uF; C_0603_1608Metric
CM1: CAM_OV7725; FFC_MOLEX_EASYON_05mm_24_INVERTED
D1, D2, D3, D4, D5, D6, D7, D8: LED WL-SMCW (150060BS84000); LED_SMD_WL-SMCW
D9: LED green; LED_0603_1608Metric
FID1, FID2, FID3, FID4: Fiducial; Fiducial_1mm_Dia_2.54mm_Outer_CopperBottom
H1, H2, H3, H4, H5, H6: CaseMountingHole; MountingHole_3.2mm_M3
H11, H12: HeatblockMountingHole; MountingHole_2.6mm
J1: USB_C_Receptacle; USB_C_Receptacle_Amphenol_12401610E4-2A
J2: FAN_12V; JSP_PH_20_SMD_RIGHT_ANGLE
J3: ER-TFT022-1; ER-TFT022_1
J5, J6: LID_12V; PinHeader_JST_1x02_P2.54mm_Vertical
JP1: Jumper; SolderJumper-2_P1.3mm_Open_RoundedPad1.0x1.5mm
L1: 4.7uH; L_Vishay_IFSC-1515AH_4x4x1.8mm
M1: Fan; 4010FanRadial
Q3, Q5, Q8, Q9: Q_NMOS_GSD; SOT-23
Q4: Q_NMOS_GSD - AO3420; SOT-23
Q6, Q7: BC847_NPN_BEC; SOT-23
R2, R3, R4, R10, R11: 4.7k; R_0603_1608Metric
R5, R6, R22, R23: 10k; R_0603_1608Metric
R7, R8, R12: 1k; R_0603_1608Metric
R13: 720 0.1%; R_0603_1608Metric
R14, R15, R24, R25: 22R; R_0603_1608Metric
R18, R19: 5k1; R_0603_1608Metric
R28, R29, R30: 15R; R_0603_1608Metric
R31: 100k; R_0603_1608Metric
SW1: SW_Push; SW_SPST_KMS221GLFS
TH1: Thermistor_NTC; C_0402_1005Metric
U2: ESP32-S2-WROVER
U3: AP63205WU; TSOT-23-6
U4: XC6206P282MR-G; SOT-23
U5: XC6206P122MR-G; SOT-23
U6: TLV1117-33; SOT-223
U8: TLA2024; Texas_R-PUQFN-N10
U9: TLC59108xPW; TSSOP-20_4.4x6.5mm_P0.65mm
U11: SRV05-4; SOT-23-6
U12: CP2104; QFN-24-1EP_4x4mm_P0.5mm_EP2.6x2.6mm
U14: IP2721_MAX12; TSSOP-16_4.4x5mm_P0.65mm
X1, X2, X4, X5, X7, X8: PAD; PAD_SMD_3mm
X3, X6: MountPad3; PAD_SMD_2x1mm
X9: GOSH LOGO; GOSH_Logo_21mm
X10: GlobalLampLogo
X11: GaudiLabs Logo; GaudiLabs_12
X12: KiCad Logo; KiCad-Logo2_5mm_SilkScreen
X13: PEACE LOGO; Peace_logo

Connections:
+1V2: C11.1, C14.1, CM1.10 (DVDD), U5.2 (VO)
+2V8: C10.1, C13.1, C15.1, CM1.4 (AVDD), R10.2, R11.2, U4.2 (VO), U8.7 (AIN3)
+3V3: C2.1, C3.1, C4.1, C5.1, C6.1, C9.1, C18.1, C21.1, C23.1, C24.1, C25.1, C27.1, C30.1, CM1.11 (DOVDD), J3.1 (LEDA), J3.7 (IM1), J3.8 (IM2), J3.35 (RD), J3.40 (VDDI), J3.41 (VDDI), J3.42 (VCI), R3.2, R4.1, R6.2, R7.1, R8.1, U2.2 (3V3), U4.3 (VI), U5.3 (VI), U6.2 (VO), U8.8 (VDD), U9.20 (VCC), U12.5 (VIO), U12.6 (VDD), U12.7 (REGIN), U12.8 (VBUS), X7.1
+5V: C16.1, C17.1, D1.2 (A), D2.2 (A), D3.2 (A), D4.2 (A), D5.2 (A), D6.2 (A), D7.2 (A), D8.2 (A), L1.2, U3.1 (FB), U6.3 (VI)
CAM_PWDN: CM1.8 (PWDN), R2.1
CAM_RST: C12.1, CM1.6 (RESET_B), J3.10 (RESET), J3.47 (YU(Y-)/RESET), Q6.3 (C), R8.2, SW1.2, U2.41 (EN), U9.17 (~RESET)
CC1: J1.A5 (CC1), R18.2, U14.13 (CC1)
CC2: J1.B5 (CC2), R19.1, U14.12 (CC2)
CSI_HREF: CM1.9 (HREF/HSYNC), U2.11 (IO08)
CSI_PCLK: C8.1, CM1.17 (PCLK), U2.9 (IO06)
CSI_VSYNC: CM1.7 (VSYNC), U2.12 (IO09)
CSI_XCKL: CM1.13 (XCLK), U2.10 (IO07)
CSI_Y2: CM1.19 (D2), U2.4 (IO01)
CSI_Y3: CM1.21 (D3), U2.6 (IO03)
CSI_Y4: CM1.22 (D4), U2.7 (IO04)
CSI_Y5: CM1.20 (D5), U2.5 (IO02)
CSI_Y6: CM1.18 (D6), U2.8 (IO05)
CSI_Y7: CM1.16 (D7), U2.34 (IO40)
CSI_Y8: CM1.14 (D8), U2.33 (IO39)
CSI_Y9: CM1.12 (D9), U2.35 (IO41)
D+: J1.A6 (D+), J1.B6 (D+), R14.1, R25.1
D-: J1.A7 (D-), J1.B7 (D-), R15.1, R24.1
DTR: Q7.2 (E), R23.1, U12.23 (~DTR)
FAN_PWM: Q4.1 (G), U2.27 (IO33)
GND: C2.2, C3.2, C4.2, C5.2, C6.2, C8.2, C9.2, C10.2, C11.2, C12.2, C13.2, C14.2, C15.2, C16.2, C17.2, C18.2, C19.2, C20.2, C21.2, C22.2, C23.2, C24.2, C25.2, C27.2, C28.2, C30.2, CM1.2 (AGND), CM1.15 (DGND), D9.1 (K), J1.A1 (GND), J1.A12 (GND), J1.B1 (GND), J1.B12 (GND), J3.6 (IM0), J3.9 (IM3), J3.11 (VSYNC), J3.12 (HSYNC), J3.13 (DOTCLK), J3.14 (DE), J3.15 (DB17), J3.16 (DB16), J3.17 (DB15), J3.18 (DB14), J3.19 (DB13), J3.20 (DB12), J3.21 (DB11), J3.22 (DB10), J3.23 (DB9), J3.24 (DB8), J3.25 (DB7), J3.26 (DB6), J3.27 (DB5), J3.28 (DB4), J3.29 (DB3), J3.30 (DB2), J3.31 (DB1), J3.32 (DB0), J3.43 (GND), J3.48 (GND), J3.49 (GND), J3.50 (GND), J6.2, Q3.2 (S), Q4.2 (S), Q5.2 (S), Q8.2 (S), R2.2, R12.2, R13.1, R18.1, R19.2, SW1.1, TH1.2, U2.1 (GND), U2.26 (GND), U2.42 (GND), U2.43 (GND), U3.4 (GND), U4.1 (GND), U5.1 (GND), U6.1 (GND), U8.1 (ADDR), U8.3 (GND), U9.2 (A0), U9.3 (A1), U9.4 (A2), U9.5 (A3), U9.8 (GND), U9.13 (GND), U9.16 (GND), U12.2 (GND), U12.25 (GND), U14.5 (GND), X2.1, X4.1
HEATER_NTC: R11.1, TH1.1, U8.4 (AIN0), X1.1
HEATER_PWM: Q5.1 (G), U2.24 (IO21)
I2C_SCL: CM1.5 (SCL), J3.44 (XR(X+)/SCL), R3.1, U2.19 (IO16), U8.10 (SCL), U9.18 (SCL)
I2C_SDA: CM1.3 (SDA), J3.45 (YD(Y+)/SDA), R4.2, U2.20 (IO17), U8.9 (SDA), U9.19 (SDA)
IO0: Q7.3 (C), U2.3 (IO00)
LID_NTC: J6.1, R10.1, U8.5 (AIN1)
LID_PWM: Q3.1 (G), U2.25 (IO26)
unnamed: C7.1, L1.1, U3.5 (SW)
unnamed: C7.2, U3.6 (BST)
unnamed: D1.1 (K), U9.6 (~OUT0)
unnamed: D2.1 (K), U9.7 (~OUT1)
unnamed: D3.1 (K), U9.9 (~OUT2)
unnamed: D4.1 (K), U9.10 (~OUT3)
unnamed: D5.1 (K), U9.11 (~OUT4)
unnamed: D6.1 (K), U9.12 (~OUT5)
unnamed: D7.1 (K), U9.14 (~OUT6)
unnamed: D8.1 (K), U9.15 (~OUT7)
unnamed: D9.2 (A), R7.2
unnamed: J2.2, Q4.3 (D)
unnamed: J3.2 (LEDK1), R28.2
unnamed: J3.3 (LEDK2), R29.2
unnamed: J3.4 (LEDK3), R30.2
unnamed: J5.2, Q3.3 (D)
unnamed: JP1.1, U14.11 (SEL)
unnamed: JP1.2, R31.1
unnamed: Q6.1 (B), R23.2
unnamed: Q7.1 (B), R22.2
unnamed: Q8.3 (D), R28.1, R29.1, R30.1
unnamed: Q9.1 (G), U14.1 (VBUSG)
unnamed: R6.1, U12.9 (~RST)
unnamed: R5.2, R12.1, U8.6 (AIN2)
unnamed: R13.2, U9.1 (REXT)
unnamed: R14.2, U2.23 (USB_D+)
unnamed: R15.2, U2.22 (USB_D-)
unnamed: R24.2, U12.4 (D-)
unnamed: R25.2, U12.3 (D+)
RTS: Q6.2 (E), R22.1, U12.19 (~RTS)
RX: U2.37 (TXD0), U12.20 (RXD)
RXLED: U12.13 (RXT/GPIO.1)
TFT_BACKLIGHT: Q8.1 (G), U2.21 (IO18)
TFT_CS: J3.38 (CSX), U2.28 (IO34)
TFT_DC: J3.36 (WRX(D/CX)), U2.31 (IO37)
TFT_MOSI: J3.34 (SDI), U2.29 (IO35)
TFT_SCLK: J3.37 (D/CX(SCL)), U2.30 (IO36)
TX: U2.38 (RXD0), U12.21 (TXD)
TXLED: U12.14 (TXT/GPIO.0)
VBUS: C19.1, C20.1, C28.1, J2.1, J5.1, Q5.3 (D), Q9.2 (S), R5.1, U3.2 (EN), U3.3 (IN), U14.16 (VBUS), X5.1, X8.1
VIN: C22.1, J1.A4 (VBUS), J1.A9 (VBUS), J1.B4 (VBUS), J1.B9 (VBUS), Q9.3 (D), R31.2, U14.2 (VIN)

Notes on the sheet:
LID
RESET CIRCUIT
ADS1113IDGS
Soldered 12V Unsoldered 9V
LM2675
3.3V / 2.8V ?
HEATER
MCP3422
2576 / 2596 /
PSRAM USE
cp2104
CAMERA FOR FLUORECENCE DETECTION
EXCITATION LEDS
USB CONNECTION
Removed CamReset Circuit
240mA 8 * 10mA = 80mA
ADP1108AR
TLA2022
FAN
ws2814
ADS1114IDGS
CONTROLLER ESP32-S2
must be low on boot

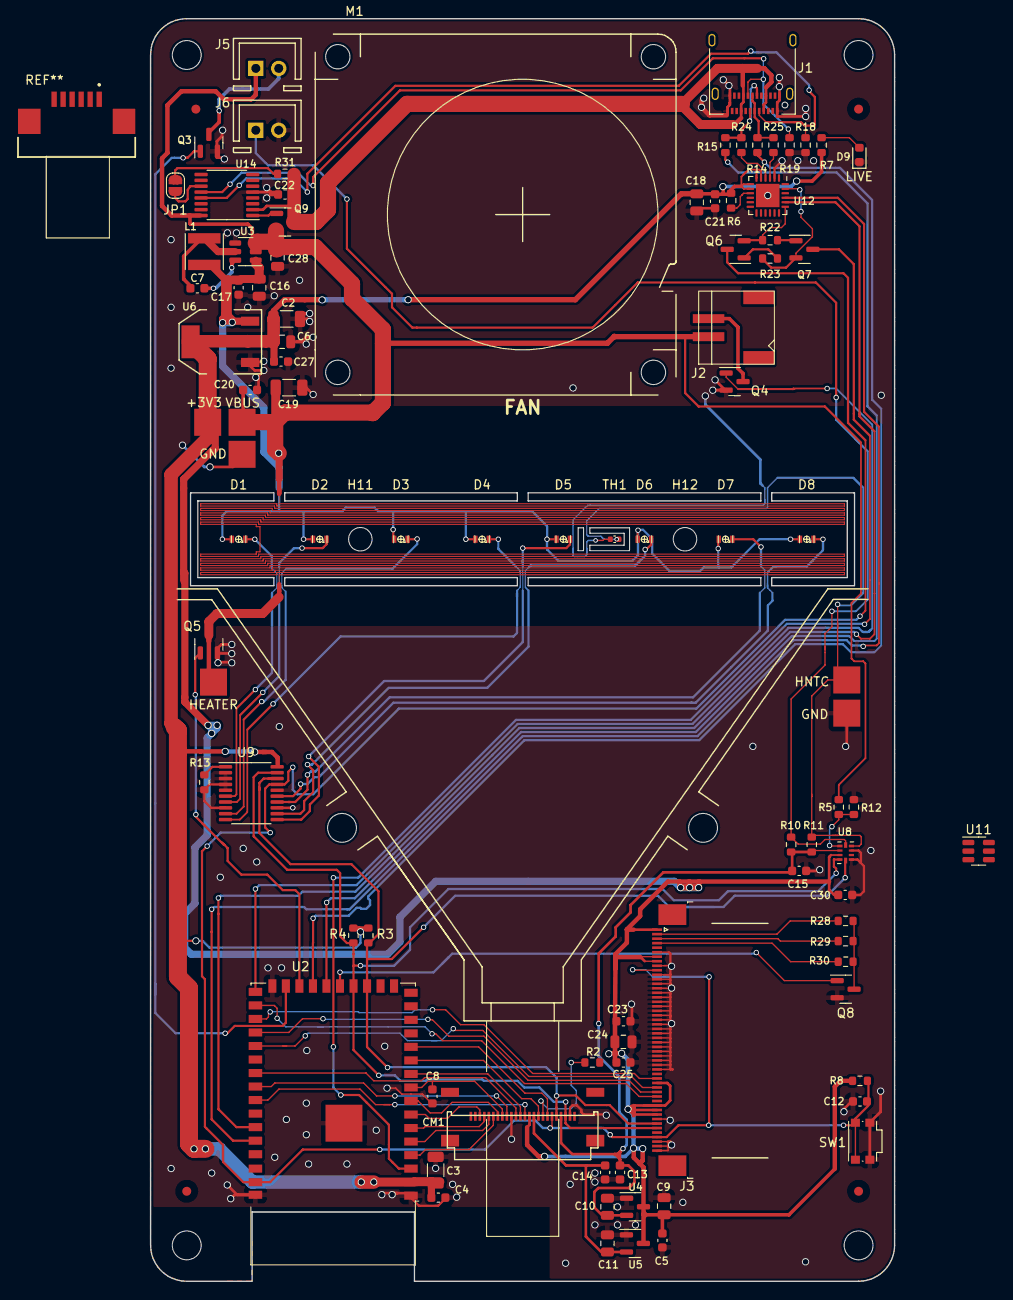
[picture p41: board qCamPCR.kicad_pcb from above]

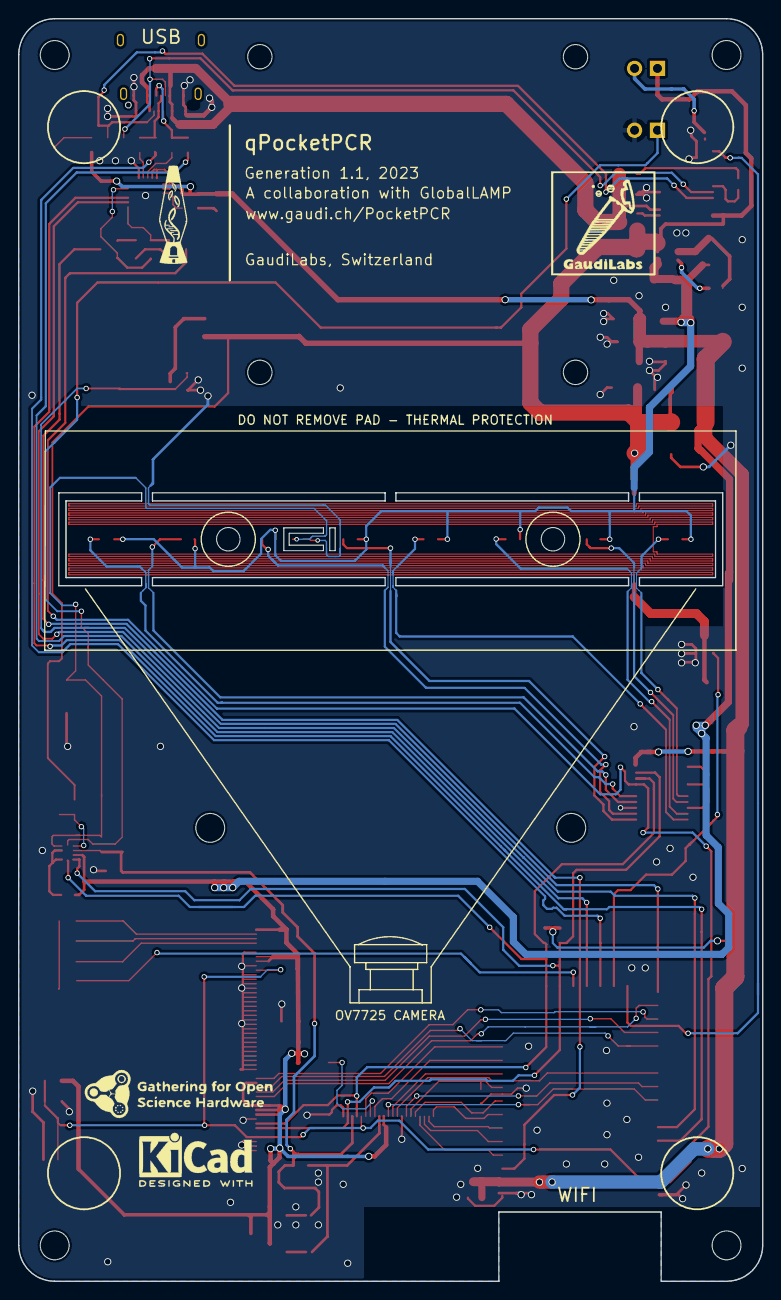
[picture p42: board qCamPCR.kicad_pcb from below]

Board: 2 copper layers, 82.5 x 140.0 mm, 112 parts (4 on the bottom side), 71 nets.
