GaudiLabs/qPocketPCR/Software/pPocketPCR_Main/Roboto_Medium7pt7b.h

const uint8_t Roboto_Medium7pt7bBitmaps[] PROGMEM = {
    0x00, 0xFF, 0xFC, 0xF0, 0xB6, 0xD0, 0x34, 0x48, 0x97, 0xF2, 0xC5, 0x3F,
    0xA4, 0x48, 0xB0, 0x10, 0x47, 0xB3, 0xC7, 0x07, 0x03, 0x0E, 0x1C, 0xDE,
    0x10, 0xE0, 0x59, 0x25, 0x17, 0x8E, 0x80, 0xB8, 0xF4, 0x5B, 0x4D, 0x03,
    0x80, 0x78, 0x48, 0xCC, 0x58, 0x70, 0xF2, 0x9A, 0x8E, 0xCE, 0x7B, 0xF0,
    0x12, 0x44, 0xCC, 0x88, 0xCC, 0x44, 0x21, 0x84, 0x22, 0x33, 0x11, 0x33,
    0x22, 0x48, 0x10, 0x4F, 0xCC, 0x79, 0x20, 0x18, 0x30, 0x67, 0xF1, 0x83,
    0x06, 0x00, 0x56, 0xF0, 0xF0, 0x08, 0xC4, 0x23, 0x10, 0x8C, 0x42, 0x20,
    0x7B, 0x3C, 0xE1, 0x86, 0x18, 0x73, 0xCD, 0xE0, 0x37, 0xB3, 0x33, 0x33,
    0x33, 0x7B, 0x38, 0xC3, 0x0C, 0x63, 0x18, 0xC3, 0xF0, 0x7B, 0x30, 0xC3,
    0x38, 0x30, 0xC3, 0xCD, 0xE0, 0x0C, 0x1C, 0x34, 0x24, 0x64, 0xC4, 0xFF,
    0x0C, 0x0C, 0x0C, 0x7F, 0x0C, 0x3E, 0xCC, 0x10, 0x71, 0xCD, 0xE0, 0x39,
    0x8C, 0x3E, 0xCF, 0x1C, 0x71, 0xCD, 0xE0, 0xFE, 0x0C, 0x18, 0x20, 0xC1,
    0x06, 0x08, 0x30, 0x60, 0x7B, 0x3C, 0xF3, 0x7B, 0x3C, 0xF3, 0xCD, 0xE0,
    0x7B, 0x3C, 0xF3, 0xCD, 0xF0, 0xC3, 0x19, 0xC0, 0xF0, 0x0F, 0x6C, 0x00,
    0x1B, 0x78, 0x00, 0x04, 0x7F, 0x38, 0x38, 0x30, 0xFC, 0x00, 0x3F, 0x83,
    0x83, 0x87, 0xF3, 0x00, 0x7B, 0x38, 0x63, 0x0C, 0x61, 0x00, 0x30, 0xC0,
    0x1F, 0x06, 0x19, 0x81, 0x23, 0x98, 0x93, 0x32, 0x64, 0x4C, 0x99, 0x93,
    0x39, 0xB9, 0x00, 0x30, 0x81, 0xF0, 0x08, 0x0E, 0x07, 0x06, 0xC3, 0x63,
    0x19, 0xFC, 0xC6, 0xC1, 0xE0, 0xC0, 0xFD, 0x8F, 0x1E, 0x3F, 0xD8, 0xF1,
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
    {259, 6, 10, 8, 1, -9},   // 0x46 'F'
    {267, 8, 10, 10, 1, -9},  // 0x47 'G'
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
};

const GFXfont Roboto_Medium7pt7b PROGMEM = {
    (uint8_t *)Roboto_Medium7pt7bBitmaps,
    (GFXglyph *)Roboto_Medium7pt7bGlyphs, 0x20, 0x7E, 16};

// Approx. 1370 bytes
