GaudiLabs/qPocketPCR/Software/pPocketPCR_Main/GaudiSans7pt7b.h

const uint8_t GaudiSans7pt7bBitmaps[] PROGMEM = {
  0x00, 0xFF, 0x40, 0xB6, 0xD0, 0x14, 0x28, 0x51, 0xF1, 0x45, 0x1F, 0x14, 
  0x28, 0x50, 0x00, 0x10, 0xFA, 0x4C, 0x89, 0x0E, 0x07, 0x09, 0x93, 0x25, 
  0xF0, 0x80, 0x00, 0x62, 0x49, 0x25, 0x0C, 0x80, 0x80, 0x40, 0x4C, 0x29, 
  0x24, 0x91, 0x80, 0x30, 0x48, 0x48, 0x48, 0x30, 0x52, 0x9A, 0x8C, 0x8E, 
  0xFA, 0xF0, 0x29, 0x49, 0x24, 0x91, 0x22, 0x00, 0x89, 0x12, 0x49, 0x25, 
  0x28, 0x00, 0x5D, 0x50, 0x00, 0x00, 0x3F, 0x00, 0x00, 0x00, 0xD8, 0xE0, 
  0xC0, 0x11, 0x22, 0x24, 0x44, 0x88, 0x7A, 0x18, 0x61, 0x86, 0x18, 0x61, 
  0x85, 0xE0, 0x13, 0x59, 0x11, 0x11, 0x11, 0x3C, 0x85, 0x0A, 0x10, 0x41, 
  0x04, 0x10, 0x40, 0xFC, 0x00, 0x3C, 0x85, 0x08, 0x11, 0xC0, 0x40, 0xA1, 
  0x42, 0x78, 0x00, 0x04, 0x18, 0x51, 0x24, 0x50, 0xBF, 0x82, 0x04, 0x08, 
  0x00, 0x7E, 0x81, 0x02, 0x07, 0xC0, 0x40, 0x81, 0x42, 0x78, 0x00, 0x7A, 
  0x18, 0x20, 0xFA, 0x18, 0x61, 0x85, 0xE0, 0xFC, 0x10, 0x82, 0x10, 0x42, 
  0x08, 0x41, 0x00, 0x3C, 0x85, 0x0A, 0x13, 0xC8, 0x50, 0xA1, 0x42, 0x78, 
  0x00, 0x7A, 0x18, 0x61, 0x7C, 0x10, 0x41, 0x85, 0xE0, 0xC0, 0x0C, 0x40, 
  0x0D, 0xC0, 0x0C, 0xCC, 0x30, 0x30, 0x30, 0xFC, 0x00, 0xC0, 0xC0, 0xC3, 
  0x33, 0x00, 0x74, 0x62, 0x11, 0x10, 0x80, 0x01, 0x00, 0x1F, 0x82, 0x04, 
  0x40, 0x28, 0xF9, 0x91, 0x19, 0x11, 0x91, 0x19, 0x12, 0x8F, 0xC4, 0x00, 
  0x20, 0x01, 0xF8, 0x08, 0x04, 0x05, 0x02, 0x82, 0x21, 0x11, 0xFC, 0x82, 
  0x80, 0xC0, 0x40, 0xFD, 0x06, 0x0C, 0x1F, 0xD0, 0x60, 0xC1, 0x83, 0xF8, 
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
  {   746,  11,  11,  15,    0,  -10 },   // 0x85 'non-printable'
  {   762,  11,  11,  15,    0,  -10 },   // 0x86 'non-printable'
  {   778,  12,  11,  14,    0,  -10 },   // 0x87 'non-printable'
  {     0,   0,   0,   0,    0,    0 },   // 0x88 'non-printable'
  {     0,   0,   0,   0,    0,    0 },   // 0x89 'non-printable'
  {     0,   0,   0,   0,    0,    0 },   // 0x8A 'non-printable'
  {     0,   0,   0,   0,    0,    0 },   // 0x8B 'non-printable'
  {     0,   0,   0,   0,    0,    0 },   // 0x8C 'non-printable'
  {     0,   0,   0,   0,    0,    0 },   // 0x8D 'non-printable'
  {     0,   0,   0,   0,    0,    0 },   // 0x8E 'non-printable'
  {     0,   0,   0,   0,    0,    0 },   // 0x8F 'non-printable'
  {     0,   0,   0,   0,    0,    0 },   // 0x90 'non-printable'
  {     0,   0,   0,   0,    0,    0 },   // 0x91 'non-printable'
  {     0,   0,   0,   0,    0,    0 },   // 0x92 'non-printable'
  {     0,   0,   0,   0,    0,    0 },   // 0x93 'non-printable'
  {     0,   0,   0,   0,    0,    0 },   // 0x94 'non-printable'
  {     0,   0,   0,   0,    0,    0 },   // 0x95 'non-printable'
  {     0,   0,   0,   0,    0,    0 },   // 0x96 'non-printable'
  {     0,   0,   0,   0,    0,    0 },   // 0x97 'non-printable'
  {     0,   0,   0,   0,    0,    0 },   // 0x98 'non-printable'
  {     0,   0,   0,   0,    0,    0 },   // 0x99 'non-printable'
  {     0,   0,   0,   0,    0,    0 },   // 0x9A 'non-printable'
  {     0,   0,   0,   0,    0,    0 },   // 0x9B 'non-printable'
  {     0,   0,   0,   0,    0,    0 },   // 0x9C 'non-printable'
  {     0,   0,   0,   0,    0,    0 },   // 0x9D 'non-printable'
  {     0,   0,   0,   0,    0,    0 },   // 0x9E 'non-printable'
  {     0,   0,   0,   0,    0,    0 },   // 0x9F 'non-printable'
  {     0,   0,   0,   0,    0,    0 },   // 0xA0 ' '
  {     0,   0,   0,   0,    0,    0 },   // 0xA1 '¡'
  {     0,   0,   0,   0,    0,    0 },   // 0xA2 '¢'
  {     0,   0,   0,   0,    0,    0 },   // 0xA3 '£'
  {     0,   0,   0,   0,    0,    0 },   // 0xA4 '¤'
  {     0,   0,   0,   0,    0,    0 },   // 0xA5 '¥'
  {     0,   0,   0,   0,    0,    0 },   // 0xA6 '¦'
  {     0,   0,   0,   0,    0,    0 },   // 0xA7 '§'
  {     0,   0,   0,   0,    0,    0 },   // 0xA8 '¨'
  {     0,   0,   0,   0,    0,    0 },   // 0xA9 '©'
  {     0,   0,   0,   0,    0,    0 },   // 0xAA 'ª'
  {     0,   0,   0,   0,    0,    0 },   // 0xAB '«'
  {     0,   0,   0,   0,    0,    0 },   // 0xAC '¬'
  {     0,   0,   0,   0,    0,    0 },   // 0xAD 'non-printable'
  {     0,   0,   0,   0,    0,    0 },   // 0xAE '®'
  {     0,   0,   0,   0,    0,    0 },   // 0xAF '¯'
  {   795,   4,   4,   4,    0,   -9 }    // 0xB0 '°'
};

const GFXfont GaudiSans7pt7b PROGMEM = {
  (uint8_t  *)GaudiSans7pt7bBitmaps,        
  (GFXglyph *)GaudiSans7pt7bGlyphs, 0x20, 0xB0,         23 };

// Approx. 1354 bytes
