GaudiLabs/qPocketPCR/Software/pPocketPCR_Main/neuropol10pt7b.h

const uint8_t neuropol10pt7bBitmaps[] PROGMEM = {
  0x00, 0xFF, 0xFF, 0xFF, 0xFF, 0x8F, 0xC0, 0xCF, 0x3C, 0xF3, 0xCC, 0x03, 
  0x8E, 0x03, 0x8C, 0x07, 0x1C, 0x07, 0x1C, 0x7F, 0xFF, 0x7F, 0xFF, 0x0E, 
  0x30, 0x0C, 0x70, 0xFF, 0xFE, 0xFF, 0xFE, 0x38, 0xE0, 0x38, 0xE0, 0x31, 
  0xC0, 0x71, 0xC0, 0x01, 0x80, 0x3F, 0x80, 0x7F, 0x80, 0xE1, 0x80, 0xC1, 
  0x80, 0xC1, 0x80, 0xE1, 0x80, 0x7F, 0xFC, 0x3F, 0xFE, 0x01, 0x87, 0x01, 
  0x83, 0x01, 0x83, 0x01, 0x87, 0xFF, 0xFE, 0xFF, 0xFC, 0x01, 0x80, 0x7F, 
  0x81, 0x81, 0xFF, 0x83, 0x03, 0x03, 0x0C, 0x06, 0x06, 0x30, 0x0C, 0x0C, 
  0xC0, 0x18, 0x1B, 0x80, 0x3F, 0xF6, 0xFF, 0x3F, 0xDB, 0xFF, 0x00, 0x66, 
  0x06, 0x01, 0x8C, 0x0C, 0x03, 0x18, 0x18, 0x0C, 0x30, 0x30, 0x30, 0x7F, 
  0xE0, 0x40, 0x7F, 0x80, 0x0F, 0xF0, 0x07, 0xFF, 0x80, 0xC0, 0x30, 0x18, 
  0x06, 0x03, 0x00, 0xC0, 0x78, 0xF0, 0x07, 0xFC, 0x01, 0xFC, 0x0C, 0xF9, 
  0xE1, 0x98, 0x0F, 0x33, 0x00, 0xFE, 0x70, 0x07, 0xC7, 0xFF, 0xFC, 0x7F, 
  0xFD, 0xC0, 0xFF, 0xC0, 0x03, 0xD9, 0x8C, 0x63, 0x18, 0xC6, 0x31, 0x8C, 
  0x63, 0x18, 0xC6, 0x31, 0xC7, 0x9C, 0x07, 0x8C, 0x31, 0x8C, 0x63, 0x18, 
  0xC6, 0x31, 0x8C, 0x63, 0x18, 0xC6, 0x7F, 0x70, 0x0C, 0x1B, 0x6F, 0xFC, 
  0xFC, 0xFF, 0xDB, 0x60, 0xC0, 0x0C, 0x03, 0x00, 0xC0, 0x30, 0xFF, 0xFF, 
  0xF0, 0xC0, 0x30, 0x0C, 0x03, 0x00, 0xFF, 0xFC, 0xFF, 0xFF, 0xC0, 0xFC, 
  0x00, 0x03, 0x00, 0x03, 0x80, 0x03, 0x80, 0x01, 0xC0, 0x01, 0xC0, 0x01, 
  0xC0, 0x01, 0xC0, 0x00, 0xE0, 0x00, 0xE0, 0x00, 0xE0, 0x00, 0xE0, 0x00, 
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
  {  2204,  20,  13,  21,    0,  -12 }    // 0x85 'non-printable'
};

const GFXfont neuropol10pt7b PROGMEM = {
    (uint8_t *)neuropol10pt7bBitmaps,    
    (GFXglyph *)neuropol10pt7bGlyphs, 0x20, 0x85,     24};

// Approx. 2761 bytes
