GaudiLabs/qPocketPCR/Software/pPocketPCR_Main/neuropol11pt7b.h

const uint8_t neuropol11pt7bBitmaps[] PROGMEM = {
    0x00, 0xFF, 0xFF, 0xFF, 0xFF, 0xF1, 0xF8, 0xEF, 0xDF, 0xBF, 0x7E, 0xE0,
    0x01, 0xC7, 0x00, 0x71, 0x80, 0x38, 0xE0, 0x0E, 0x38, 0x3F, 0xFF, 0xCF,
    0xFF, 0xF0, 0x71, 0x80, 0x18, 0xE0, 0xFF, 0xFF, 0x3F, 0xFF, 0xC1, 0xC7,
    0x00, 0x71, 0xC0, 0x1C, 0x60, 0x0E, 0x38, 0x03, 0x8E, 0x00, 0x01, 0xC0,
    0x07, 0xF0, 0x07, 0xFC, 0x03, 0xC7, 0x00, 0xE1, 0xC0, 0x38, 0x70, 0x0E,
    0x1C, 0x03, 0xC7, 0x00, 0x7F, 0xFE, 0x0F, 0xFF, 0xE0, 0x1C, 0x3C, 0x07,
    0x07, 0x01, 0xC1, 0xC0, 0x70, 0xFF, 0xFF, 0xFB, 0xFF, 0xF8, 0x01, 0xC0,
    0x00, 0x7F, 0xC0, 0x60, 0x3F, 0xF8, 0x38, 0x0C, 0x06, 0x1C, 0x03, 0x01,
    0x86, 0x00, 0xC0, 0x63, 0x00, 0x30, 0x19, 0x80, 0x0C, 0x06, 0xEF, 0xFB,
    0xFF, 0xF7, 0xFF, 0x7F, 0xD9, 0x80, 0xC0, 0x0C, 0x60, 0x30, 0x06, 0x18,
    0x0C, 0x03, 0x86, 0x03, 0x01, 0xC1, 0x80, 0xC0, 0x60, 0x7F, 0xF0, 0x30,
    0x0F, 0xF8, 0x0F, 0xFC, 0x01, 0xFF, 0xF0, 0x0E, 0x01, 0xC0, 0x70, 0x0E,
    0x03, 0x80, 0x70, 0x0F, 0x1F, 0x00, 0x3F, 0xF0, 0x03, 0xF8, 0x1C, 0x7F,
    0xF0, 0xE7, 0x83, 0xC7, 0x38, 0x07, 0xB9, 0xC0, 0x1F, 0xCF, 0x00, 0x3E,
    0x3F, 0xFF, 0xF8, 0xFF, 0xFF, 0xE0, 0xFF, 0xFE, 0x08, 0xF7, 0xB8, 0xE3,
    0x8E, 0x38, 0xE3, 0x8E, 0x38, 0xE3, 0x8E, 0x38, 0xE3, 0x8E, 0x38, 0xE3,
    0xC7, 0x8E, 0x43, 0xC7, 0x87, 0x1C, 0x71, 0xC7, 0x1C, 0x71, 0xC7, 0x1C,
    0x71, 0xC7, 0x1C, 0x71, 0xC7, 0x1C, 0xFF, 0xB8, 0x0E, 0x01, 0xC1, 0xBB,
    0x7F, 0xF3, 0xF9, 0xFF, 0xDB, 0xB0, 0x70, 0x0E, 0x01, 0xC0, 0x38, 0x07,
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
    {903, 18, 15, 19, 1, -14},  // 0x45 'E'
    {937, 18, 15, 19, 1, -14},  // 0x46 'F'
    {971, 19, 15, 21, 1, -14},  // 0x47 'G'
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

const GFXfont neuropol11pt7b PROGMEM = {
    (uint8_t *)neuropol11pt7bBitmaps,
    (GFXglyph *)neuropol11pt7bGlyphs,
    0x20, 0x7E, 26};

// Approx. 3197 bytes
