GaudiLabs/qPocketPCR/Software/pPocketPCR_Main/neuropol12pt7b.h

const uint8_t neuropol12pt7bBitmaps[] PROGMEM = {
    0x00, 0xFF, 0xFF, 0xFF, 0xFF, 0xFF, 0xC7, 0xFC, 0xE7, 0xE7, 0xE7, 0xE7,
    0xE7, 0xE7, 0x00, 0xC1, 0x80, 0x3C, 0x78, 0x07, 0x0E, 0x01, 0xE1, 0xC0,
    0x38, 0x78, 0x07, 0x0E, 0x1F, 0xFF, 0xFB, 0xFF, 0xFF, 0x07, 0x0E, 0x01,
    0xC3, 0xC3, 0xFF, 0xFF, 0x7F, 0xFF, 0xE1, 0xC3, 0x80, 0x78, 0x70, 0x0E,
    0x1E, 0x01, 0xC3, 0x80, 0x78, 0x70, 0x06, 0x0C, 0x00, 0x1F, 0xE0, 0x0F,
    0xFC, 0x03, 0xC3, 0x80, 0x70, 0x70, 0x0E, 0x0E, 0x01, 0xC1, 0xC0, 0x38,
    0x38, 0x07, 0x87, 0x00, 0x7F, 0xFF, 0x03, 0xFF, 0xF8, 0x03, 0x87, 0x80,
    0x70, 0x70, 0x0E, 0x0E, 0x01, 0xC1, 0xC0, 0x38, 0x38, 0x07, 0x0F, 0xFF,
    0xFF, 0xDF, 0xFF, 0xE0, 0x03, 0x80, 0x00, 0x70, 0x00, 0x7F, 0xE0, 0x18,
    0x0F, 0xFF, 0x03, 0x80, 0xC0, 0x30, 0x70, 0x0C, 0x03, 0x06, 0x00, 0xC0,
    0x30, 0xC0, 0x0C, 0x03, 0x1C, 0x00, 0xC0, 0x33, 0x80, 0x0C, 0x03, 0x30,
    0x00, 0xFF, 0xF6, 0x7F, 0xE7, 0xFE, 0xEF, 0xFF, 0x00, 0x1C, 0xC0, 0x30,
    0x01, 0x8C, 0x03, 0x00, 0x38, 0xC0, 0x30, 0x07, 0x0C, 0x03, 0x00, 0x60,
    0xC0, 0x30, 0x0C, 0x0C, 0x03, 0x01, 0xC0, 0xFF, 0xF0, 0x18, 0x07, 0xFE,
    0x0F, 0xFE, 0x00, 0x3F, 0xFE, 0x00, 0xF0, 0x1E, 0x01, 0xC0, 0x1C, 0x03,
    0x80, 0x38, 0x07, 0x00, 0x70, 0x0F, 0x03, 0xE0, 0x0F, 0xBF, 0x80, 0x0F,
    0xFC, 0x00, 0x3F, 0xC0, 0x71, 0xFF, 0xC0, 0xE7, 0xC3, 0xE1, 0xCE, 0x03,
    0xE3, 0x9C, 0x01, 0xF7, 0x38, 0x01, 0xFE, 0x78, 0x00, 0xFC, 0x7F, 0xFF,
    0xFC, 0x3F, 0xFF, 0xBC, 0xFF, 0xFF, 0xC0, 0x00, 0xF7, 0xFC, 0xE3, 0x8E,
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
    {1164, 19, 18, 21, 1, -17}, // 0x45 'E'
    {1207, 20, 18, 21, 1, -17}, // 0x46 'F'
    {1252, 21, 18, 23, 1, -17}, // 0x47 'G'
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

const GFXfont neuropol12pt7b PROGMEM = {
    (uint8_t *)neuropol12pt7bBitmaps,
    (GFXglyph *)neuropol12pt7bGlyphs,
    0x20, 0x7E, 28};

// Approx. 3927 bytes
