GaudiLabs/qPocketPCR/Software/pPocketPCR_Main/neuropol15pt7b.h

const uint8_t neuropol15pt7bBitmaps[] PROGMEM = {
    0x00, 0xFF, 0xFF, 0xFF, 0xFF, 0xFF, 0xFF, 0xFF, 0xFF, 0xF0, 0x0F, 0xFF,
    0xF3, 0xFC, 0xFF, 0x3F, 0xCF, 0xF3, 0xFC, 0xFF, 0x3F, 0xCF, 0x00, 0x38,
    0x38, 0x00, 0x78, 0x3C, 0x00, 0x78, 0x78, 0x00, 0x78, 0x78, 0x00, 0xF0,
    0x78, 0x00, 0xF0, 0xF0, 0x00, 0xF0, 0xF0, 0x3F, 0xFF, 0xFF, 0x3F, 0xFF,
    0xFF, 0x3F, 0xFF, 0xFF, 0x03, 0xC3, 0xC0, 0x03, 0xC3, 0xC0, 0xFF, 0xFF,
    0xFC, 0xFF, 0xFF, 0xFC, 0xFF, 0xFF, 0xFC, 0x0F, 0x0F, 0x00, 0x0F, 0x0F,
    0x00, 0x1E, 0x0F, 0x00, 0x1E, 0x1E, 0x00, 0x1E, 0x1E, 0x00, 0x3C, 0x1E,
    0x00, 0x1C, 0x1C, 0x00, 0x00, 0x3C, 0x00, 0x00, 0x3C, 0x00, 0x0F, 0xFC,
    0x00, 0x3F, 0xFC, 0x00, 0x7F, 0xFC, 0x00, 0xF8, 0x3C, 0x00, 0xF0, 0x3C,
    0x00, 0xF0, 0x3C, 0x00, 0xF0, 0x3C, 0x00, 0xF0, 0x3C, 0x00, 0xF8, 0x3C,
    0x00, 0x7F, 0xFF, 0xF0, 0x3F, 0xFF, 0xFC, 0x0F, 0xFF, 0xFE, 0x00, 0x3C,
    0x3F, 0x00, 0x3C, 0x0F, 0x00, 0x3C, 0x0F, 0x00, 0x3C, 0x0F, 0x00, 0x3C,
    0x0F, 0x00, 0x3C, 0x3F, 0xFF, 0xFF, 0xFE, 0xFF, 0xFF, 0xFC, 0xFF, 0xFF,
    0xF0, 0x00, 0x3C, 0x00, 0x00, 0x3C, 0x00, 0x3F, 0xF8, 0x00, 0xC0, 0x1F,
    0xFF, 0x80, 0x38, 0x03, 0xFF, 0xF8, 0x0E, 0x00, 0x70, 0x07, 0x03, 0xC0,
    0x0E, 0x00, 0xE0, 0x70, 0x01, 0xC0, 0x1C, 0x1C, 0x00, 0x38, 0x03, 0x87,
    0x00, 0x07, 0x00, 0x70, 0xE0, 0x00, 0xE0, 0x0E, 0x38, 0x00, 0x1C, 0x01,
    0xCE, 0x7F, 0xF3, 0xFF, 0xF3, 0x9F, 0xFF, 0x1F, 0xFC, 0x77, 0xFF, 0xF0,
    0x00, 0x1C, 0xE0, 0x0E, 0x00, 0x07, 0x1C, 0x01, 0xC0, 0x01, 0xE3, 0x80,
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
    {1766, 24, 22, 26, 1, -21}, // 0x45 'E'
    {1832, 24, 22, 26, 1, -21}, // 0x46 'F'
    {1898, 26, 22, 28, 1, -21}, // 0x47 'G'
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

const GFXfont neuropol15pt7b PROGMEM = {
    (uint8_t *)neuropol15pt7bBitmaps,
    (GFXglyph *)neuropol15pt7bGlyphs,
    0x20, 0x7E, 35};

// Approx. 5605 bytes
