GaudiLabs/qPocketPCR/(commit log)

2022-08-16 First commit of PCB files prototype.
    [qCamPCR-B_Cu.gbr, qCamPCR-B_Mask.gbr, qCamPCR-B_Paste.gbr, qCamPCR-B_SilkS.gbr, qCamPCR-Edge_Cuts.gbr, qCamPCR-F_Cu.gbr, qCamPCR-F_Mask.gbr, qCamPCR-F_Paste.gbr]
2022-09-23 Various Demo and Developpement Code Beta
    [SelfieCam.stl, t-camera-plus_button.stl, t-camera-plus_top.stl]
2025-11-05 first full release getting there
    [#HeatedLidPCB.dwg, BezzelClip.SLDPRT, BlueLED0402.SLDPRT, C12401610_3.SLDPRT, Cam.SLDPRT, CapHeatedNewClip.SLDPRT, CarbonPatch.SLDPRT, Display2_2.SLDPRT]
2025-11-05 First Full Release Getting there..
    [SelfieCam.stl, t-camera-plus_button.stl, t-camera-plus_top.stl]
